asdfgh0318/arabskie_gogle/cad/img/shroud.png

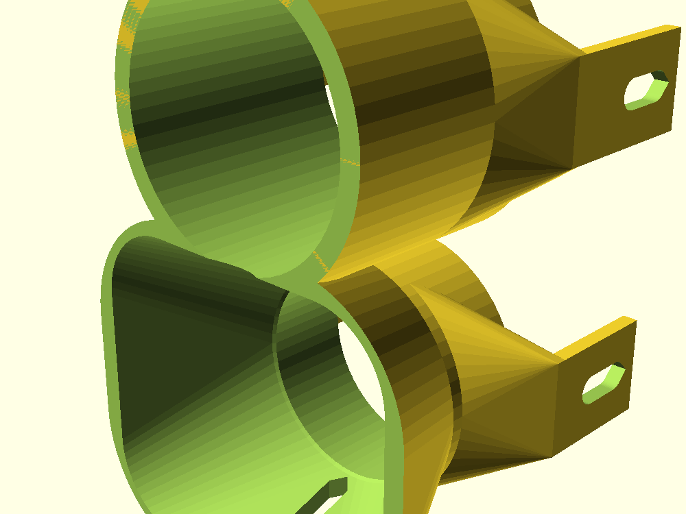
cad/img/shroud.png
