asdfgh0318/arabskie_gogle/cad/img/tac_front.png

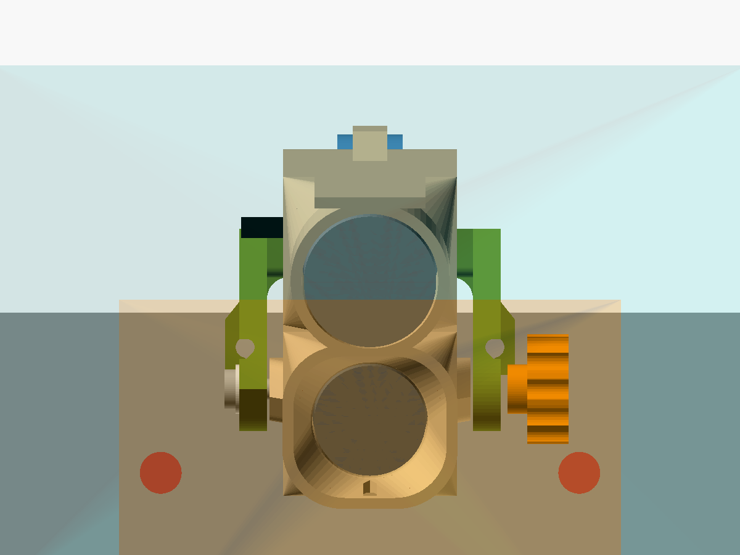
cad/img/tac_front.png
