asdfgh0318/arabskie_gogle/README.md

# arabskie_gogle

Termowizja na hełmie: gogle FPV (Fat Shark Dominator HDO?) + dwukanałowa kamera termowizyjna
(BZB UAS) + mocowania GoPro (VHB) na kasku Protec + mały sterownik (ESP32 / XIAO) z przyciskami.

Status: **definiowanie założeń** — patrz [ZALOZENIA.md](ZALOZENIA.md). Nic nie projektujemy,
dopóki cele i otwarte pytania nie są zamknięte.

## Struktura
- `ZALOZENIA.md` — cele, wymagania, otwarte pytania (dokument nadrzędny)
- `research/` — notatki z researchu (pozycja kamer, ergonomia, protokół kamery)
- `papers/` — pobrane źródła (PDF) + plik z cytatami
- `cad/` — modele do druku 3D (adapter gogle↔kask, mocowanie kamery, obudowa sterownika)
- `firmware/` — sterownik kamery (ESP32/XIAO)
- `photos/` — zdjęcia sprzętu, wymiary
