asdfgh0318/arabskie_gogle/papers/extracts_pod_ergonomics_mount.md

# Extracts — pod ergonomics (gloved, blind) and attachment to the HDO2 shell

Track 07c of `arabskie_gogle`. Verbatim passages from files in `papers/` that I downloaded **and read**,
with page/section. Line breaks are joined. "[img]" marks values read from a figure/drawing image
(the image is saved in `papers/pod_ergo_img/`), not from text. The report is
`research/07c_pod_ergonomics_mount.md`; where the two differ, **these source files govern**.

Page numbers: MIL-STD-1472H "p." = printed page number (PDF page = printed + 17).
HIDH "p." = printed page number.

---

## E1. MIL-STD-1472H, DoD Design Criteria Standard: Human Engineering (15 September 2020)
File: `pod_MIL-STD-1472H_2020_human_engineering.pdf` / `.txt` (from everyspec.com, "Downloaded from
https://www.everyspec.com" on every page). Pages 34, 70 and 71 are image-only in the PDF; they were
rendered and read: `pod_ergo_img/MIL1472H_p34_fig1_shape_coding_dims.png`,
`MIL1472H_p70_fig8_knobs_text.png`, `MIL1472H_p71_fig9_knob_shapes.png`.

**E1.1 Handwear (§5.1.1.1.1.5, p.27).**
> "5.1.1.1.1.5 Compatibility with handwear. Controls shall be compatible with handwear to be utilized in the
> anticipated environment. Unless specified for glove use, all dimensions cited herein are for bare hands and
> shall be adjusted for use with gloves or mittens (see language regarding gloves in table VII)."

**E1.2 Spacing (§5.1.1.3.7, p.31).**
> "5.1.1.3.7 Spacing. Minimum spacing between controls shall comply with table III. Spacing between a control
> and any adjacent obstruction shall be as shown by the figures referenced in table III. Minimum spacing shown
> shall be increased for operation with gloves, mittens, or CBRNE or other mission-required PPE when such
> operation is a system requirement (see 5.1.1.1.1.5 and table VII)."

**E1.3 Table III, "Minimum edge-to-edge separation distances for mechanical controls" (p.32).** Rows/columns
as extracted:
> "Push Buttons 2/ | 13 mm (0.5 in) [toggle] | See figure 14 | 13 mm (0.5 in) [continuous rotary] | 13 mm (0.5 in)
> [rotary selector] | 13 mm (0.5 in) [thumbwheel]"
> "Continuous Rotary Controls | 19 mm (0.75 in) | 13 mm (0.5 in) | See figure 12 | 25 mm (1 in) | 19 mm (0.75 in)"
> "NOTES: 1/ All values are for one-hand operation. All values are for bare-handed operation. 2/ For push buttons
> not separated by barriers."

**E1.4 Table IV, coding (p.32–33).** Shape, size, location and mode-of-operation coding are marked as
"Improves nonvisual identification (tactile and kinesthetic)"; shape, size and mode of operation are marked
"May be less effective if user wears gloves".

**E1.5 Size coding (§5.1.1.4.3, p.33).**
> "5.1.1.4.3 Size-coding. No more than three different sizes shall be used to code controls for discrimination by
> absolute size."
> "5.1.1.4.3.2 Knob diameter. When knob diameter is used as the coding parameter, the differences between
> diameters shall be not less than 13 mm (0.5 in)."
> "5.1.1.4.3.3 Knob thickness. When knob thickness is the coding parameter, the differences between thicknesses
> shall be not less than 10 mm (0.4 in)."

**E1.6 Shape coding (§5.1.1.4.4, p.33).**
> "5.1.1.4.4.1.1 Interference. The coded feature shall not interfere with ease of control manipulation."
> "5.1.1.4.4.1.2 Identifiable by hand. Shapes shall be identifiable by hand and eye regardless of the position and
> orientation of the control knob or handle."
> "5.1.1.4.4.1.3 Identifiable with gloves. Shapes shall be tactually identifiable when gloves must be worn."
> "5.1.1.4.4.1.4 Number of shapes. The number of shapes to be identified by each user based on absolute
> discrimination shall be not more than 10."

**E1.7 Shape coding, p.34 (image-only page, read from render).**
> "5.1.1.4.4.1.5 Attached to shaft. Shape-coded knobs and handles shall be positively and non-reversibly attached
> to their shafts to preclude incorrect attachment when replacement is required."
> "5.1.1.4.4.1.6 Touch alone. For knobs that must be recognized by touch alone, easily recognizable knob shapes
> shall be used (see figure 1)."
> "5.1.1.4.4.2 Control dimensions. Minimum control dimensions when users must distinguish controls by shape alone
> shall be as follows: a. Height: 13 mm (0.5 in) or larger. b. Width: 13 mm (0.5 in) or larger. c. Depth: 6.5 mm
> (0.25 in) or larger."
Figure 1 "Easily recognizable knob shapes" shows cylinder, disc, cube, cross, triangle prism, dome, bar, ring,
etc. [img].

**E1.8 Blind operation (§5.1.1.6, p.35).**
> "5.1.1.6 Blind operation. Where "blind" operation is necessary, hand controls shall be shape coded, or separated
> from adjacent controls by at least 125 mm (5 in) (see 5.1.1.4.2 and 5.1.1.4.4)."

**E1.9 Gloss (§5.1.1.4.5.5, p.35).**
> "5.1.1.4.5.5 Gloss finishes. Gloss finishes shall not be used in areas subject to darkened conditions for night
> operations."

**E1.10 Accidental actuation (§5.1.1.7.4, p.35–36).**
> "b. Recess, shield, or otherwise surround the control by physical barriers. The control shall be entirely
> contained within the recess or barrier envelope."
> "e. Provide the control with movement resistance (e.g., viscous or coulomb friction, spring-loading, or inertia)
> so that definite or sustained effort is required for actuation."
> "g. Design the control for operation by rotary action."

**E1.11 Table VII, Keyboards (p.47).** Dimensions (square): "Minimum 10 mm (0.4 in) [bare] | 19 mm (0.75 in)
[arctic mittens 1/] | 15 mm (0.6 in) [2/]"; "Preferred 13 mm | 19 mm | 18 mm (0.7 in)". Vehicle applications:
"Minimum 10 mm (0.4 in) [bare] 19 mm (0.75 in) [gloved hand] 2.8 N (9.9 oz) [numeric input]"; "Preferred ... 13 mm
(0.5 in) [separation]"; "Maximum 25 mm (1 in) 25 mm (1 in) 6.7 N (23.7 oz)".
> "1/ Trigger finger type; other parameters are unchanged from those of bare-handed operation."
> "2/ Standard cotton flame-resistant anti-flash gloves (i.e., Navy flash gloves [as defined in MIL-G-2874])."
> "3/ For membrane keys, preferred displacement is 0.7 mm (0.03 in) and resistance shall be not less than 2.0 N
> (7.2 oz). Membrane keys shall also incorporate positive tactile feedback (e.g., "snap" action)."
Column headers (verification): "Bare Hand | Arctic Mittens 1/ | 2/" — so in Table VII **19 mm belongs to arctic
mittens** (note 1/, trigger-finger type) and **15 mm to flash gloves** (note 2/). The "Vehicle Applications"
gloved 19 mm carries no footnote.

**E1.12 Figure 6, discrete rotary selector switch (p.66).** Displacement (A): "Minimum 15° (262 mrad) [1/]
30° (525 mrad) [2/]"; "Maximum 40° (700 mrad) 90° (1,570 mrad)". (Verification, same figure:) Dimensions
"L, Length 25 mm (1 in) min, 100 mm (4 in) max; W, Width 25 mm max; H, Depth 16 mm (0.625 in) min, 75 mm (3 in)
max"; Resistance "115 mN·m (1 in-lbf)" min, "680 mN·m (6 in-lbf)" max. p.67: "5.1.4.1.1.1.4 Positions. A rotary
selector switch that is not visible to the user during normal system operation shall have no more than 12
positions."
> "1/ For facilitating performance." "2/ When special engineering requirements demand large separation or when
> tactually ("blind") positioned controls are required."
Separation: "One-hand random ... Minimum 25 mm (1 in) ... Preferred 50 mm (2 in)".

**E1.13 Knob mounting (§5.1.4.1.1.1.9, p.67).**
> "5.1.4.1.1.1.9 Knob mounting. The rotary selector knob attachment shall preclude the possibility of the knob
> slipping on the shaft and the knob being replaced with the pointing end opposite from its correct position."

**E1.14 Knobs, p.70–71 (image-only pages, read from renders).**
> "5.1.4.1.2.1.3 Shapes. Knobs that perform the same function shall have the same shape." (p.70)
> "5.1.4.1.2.1.4 Rims. All rotary adjustment knobs shall have rims with surfaces capable of obtaining a secure
> grasp." "5.1.4.1.2.1.4.1 Knurled surfaces. Very small knobs shall have knurled surfaces to provide maximum
> torqueing capability." "5.1.4.1.2.1.4.2 Serrated rims. Intermediate and larger size knobs shall have serrated
> rims for low torque applications." "5.1.4.1.2.1.6 Rounded edges. All edges shall be rounded in order to minimize
> the potential injuries associated with small, sharp knob designs." "5.1.4.1.2.1.7 Dimensions, torque, and
> separation. The dimensions of knobs shall be within the limits specified on figure 10. Within these ranges, knob
> size is relatively unimportant, provided the resistance is low and the knob can be easily grasped and
> manipulated." (p.71)
Figure 9 "Recommended knob shapes": (A) knobs for more than one full turn = round/fluted/knurled; (B) less than
one turn = pointer/bar shapes [img].

**E1.15 Figure 10, Knobs (p.72).** Dimensions: "A, Fingertip Grasp: H, Height 13 mm (0.5 in) min, 25 mm (1 in)
max; D, Diameter 10 mm (0.4 in) min, 100 mm (4in) max"; "B, Thumb and Finger Encircled: H 13 mm min, 25 mm max;
D 25 mm (1 in) min, 75 mm (3 in) max". Torque maximum: "32 mN·m (4.5 in-ozf)" for "≤25 mm (1 in) Diameter Knobs",
"42 mN·m (6 in–ozf)" for ">25 mm". Separation "S, One Hand Individually: Minimum 25 mm (1 in), Optimum 50 mm
(2 in)".
> "5.1.4.1.2.1.7.2 Low resistance. Knobs shall have resistance as low as possible without permitting the setting
> to be changed by vibration or merely touching the control."

**E1.16 Figure 11, ganged knobs (p.73)** separation row:
> "25 mm (1 in), add 13 mm (0.5 in) for gloves" (column A) and "50 mm (2 in), add 25 mm (1 in) for gloves" (column B)
(the only explicit "add … for gloves" knob separation figure found; it is for ganged knobs.)

**E1.17 Push buttons (§5.1.4.2.1.1, p.80).**
> "5.1.4.2.1.1.2 Shape. The push button surface shall be concave (indented) to fit the finger."
> "5.1.4.2.1.1.2.1 Concave shape impractical. When a concave surface is impractical, the surface shall provide a
> high degree of frictional resistance."
> "5.1.4.2.1.1.3 Positive indication. A positive indication of control activation shall be provided (e.g., snap
> feel, audible click, or integral light)."
> "5.1.4.2.1.1.3.1 Tactile feedback. Tactile feedback shall be the primary form of positive indication."
> "5.1.4.2.1.1.4 Channel or cover guard. A channel or cover guard shall be provided when accidental actuation of
> the control must be prevented."

**E1.18 Figure 14, Push button (finger- or hand-operated) (p.81).**
Dimensions (D, diameter): "Fingertip Bare Hand 10 mm (0.4 in) min, 25 mm (1 in) max; Gloved Hand 1/ 19 mm
(0.75 in) min"; "Thumb Bare 19 mm min, 25 mm max; Gloved 25 mm (1 in) min"; "Palm Bare 40 mm, Gloved 50 mm".
Resistance: "Single Finger 2.8 N (10 oz) min, 11 N (40 oz) max; Different Fingers 2/ 1.4 N min, 5.6 N max; Thumb
or Palm 2.8 N min, 23 N (80 oz) max".
Displacement (A): "Fingertip Minimum 2 mm (0.08 in), Maximum 6 mm (0.25 in); Thumb or Palm 3 mm (0.12 in) min,
38 mm (1.5 in) max".
Separation (S): "Single finger Bare 13 mm (0.5 in) min, 50 mm (2 in) preferred; Single finger Gloved 25 mm (1 in)
min; Single Finger Sequential 3/ 6 mm min, 13 mm preferred; Different Finger 3/ 6 mm min, 13 mm preferred; Thumb
or Palm 3/ 25 mm min, 150 mm preferred".
> "1/ For standard cotton flame-resistant anti-flash gloves (i.e., Navy flash gloves [as defined in MIL-G-2874]),
> add 5 mm (0.2 in) to Diameter (D) of bare hand dimension."
> "2/ Actuated at same time." "3/ Where gloved hand criteria are not provided, minimum shall be suitably adjusted."
> "NOTE: Figure 14 does not apply to keyboards (see 5.1.3.2)."
Note (mine): the gloved fingertip column gives 19 mm, while footnote 1/ (10 + 5) gives 15 mm. The standard does
not reconcile the two. (Verification: 19 mm equals Table VII's arctic-mitten value, 15 mm its flash-glove value,
E1.11. The gloved separation "25 mm" has no footnote, so no glove type is attached to it.)
Also on Fig. 14 (verification): Palm "Maximum 70 mm (2.8 in)" bare.

## E2. NASA Human Integration Design Handbook (HIDH), NASA/SP-2010-3407/REV1 (approved 06-05-2014)
File: `pod_NASA_HIDH_SP-2010-3407_Rev1.pdf` / `.txt` (nasa.gov). Its history log also lists a 2022 revision of
Section 4 only.

**E2.1 §10.4.2.1.4–10.4.2.1.5, p.969; Figure 10.4-1, p.970.**
> "Except for use of push buttons in keyboards, control dimensions, resistance, displacement, and separation
> between adjacent edges of finger or hand-operated push buttons should conform to the criteria in 10.6-7."
> "10.4.2.1.5 Interlocks or Barriers" (heading), then: "Mechanical interlocks or barriers may be used instead of
> the spacing required by Figure 10.4-1."
> "Figure 10.4-1 Requirements for push buttons (finger- or hand-operated). Source: MIL-STD-1472F"

**E2.2 §10.4.11, p.1019.**
> "Extravehicular activity gloves reduce tactility even when they are not pressurized. Thus, performance with
> cursor control devices that require fine motor movements is negatively affected when wearing gloves: movement
> times are slower and accuracy is also reduced. Some devices are less affected by the lack of tactility. In a
> ground-based study on gloved cursor control device (CCD) use, discrete devices with 4-way operation led to better
> performance than continuous or 2-way devices (Thompson, Meyer, Sandor, Holden, 2009)."

**E2.3 §10.5.6 Obscured controls, p.1023.**
> "Controls designed to be out of view while being operated should be spaced or shaped/textured such that the
> control can be identified with a pressurized gloved hand without line of sight."

**E2.4 §11.3.4 (suit), p.1122.**
> "Spacesuit gloves degrade hand and finger range of motion, tactile feedback, and proficiency compared to
> bare-hand operations. Depending on the design, dexterity can generally be compared to that with heavy work
> gloves. However, because of reduced tactile feedback, the size and shape of objects is more difficult to
> discern."

## E3. 3M VHB Tape 5952, Technical Data Sheet (Oct 2022, official 3M)
File: `pod_3M_VHB_5952_TDS_2022-10.pdf` / `.txt` (multimedia.3m.com).

**E3.1 p.1.**
> "3M™ VHB™ Tape 5952 is a 0.045 inch (1.1 mm) thick black double-sided acrylic foam tape with PE film liner. The
> modified acrylic adhesive on both sides bonds to a broad range of high, medium and medium/low surface energy
> substrates including metals, glass and a wide variety of plastics and paints, including many powder coated
> paints. The very conformable foam provides good contact between substrates even when they are slightly
> mismatched."
> "The following technical information and data should be considered representative or typical only and should
> not be used for specification purposes."

**E3.2 Typical performance, p.2–5** (peel p.2–3, normal tensile and overlap shear p.3, static shear and minimum
application temperature p.4, shear modulus p.5).
> "90° Peel Adhesion 22 lb/in ... Test Method: ASTM D3330 ... Backing: 5 mil Aluminum Foil"; "90° Peel Adhesion
> 39 N/cm ... ASTM D3330"
> "Normal Tensile 480 kPa ... ASTM D897 ... Dwell/Cure Time: 72.0 ... Substrate: Aluminum ... Notes: 1 in.²
> (6.45 cm²), Jaw Speed 2 in./min. (50 mm/min.)"
> "Overlap Shear Strength 550 kPa ... ASTM D1002 ... Notes: 1 in² (6.45 cm²), Jaw Speed 0.5 in/min (12.7 mm/min)"
> "Static Shear 1000 g ... ASTM D3654 ... Temp C: 23C ... Substrate: Stainless Steel ... 0.5 in² (3.23 cm²). Will
> hold listed weight for 10,000 minutes (approximately 7 day)." (500 g at 66 °C; 250 g at 93 °C)
> "Minimum Application Temperature 10 °C"
> "Shear Modulus 3 x 10^5 Pa"

**E3.3 Design Considerations, p.6–7.**
> "3M™ VHB™ 5952 family tapes bond well to high (HSE), medium (MSE), and medium/low (M/LSE) surface energy
> materials."
> "While the 3M™ VHB™ Tapes will conform to a certain amount of irregularity, they will not flow to fill gaps
> between the materials. For bonding rigid materials with normal flatness, consider use of tapes with thickness
> of 45 mils (1.1 mm) or greater. As the substrate flexibility increases thinner tapes can be considered."
> "As a general rule, for static loads, approximately four square inches of tape should be used for each pound
> (57 cm² of tape per kg) of weight to be supported in order to prevent excessive creep. For dynamic loads a useful
> design factor is 12 lb/in2 (85 kPa) for most dynamic stresses in general applications."
> "Performance in Severe Cold Temperature can be challenging. Applications which require performance at severe
> cold temperatures must be thoroughly evaluated by the user if the intended use will subject the tape product to
> high impact stresses."

**E3.4 Application, p.7–8.**
> "Clean: Most substrates are best prepared by cleaning with a 50:50 mixture of isopropyl alcohol (IPA*) and water
> prior to applying 3M™ VHB™ Tapes."
> "• Abrasion: Abrading a surface, followed by cleaning with IPA/water, can remove heavy dirt or oxidation and can
> increase surface area to improve adhesion." "• Adhesion Promoters: Priming a surface can significantly improve
> initial and ultimate adhesion to many materials such as plastics and paints."
> "Typically, good surface contact can be attained by applying enough pressure to insure that the tape experiences
> approximately 15 psi (100 kPa) pressure. Either roller or platen pressure can be used. Note that rigid surfaces
> may require 2 or 3 times that much pressure to make the tape experience 15 psi."
> "Ideal application temperature range is 70°F to 100°F (21°C to 38°C)." "Initial tape application to surfaces at
> temperatures below these suggested minimums is not recommended because the adhesive becomes too firm to adhere
> readily. However, once properly applied, low temperature holding is generally satisfactory."
> "At room temperature approximately 50% of ultimate bond strength will be achieved after 20 minutes, 90% after 24
> hours and 100% after 72 hours."
> (verification, p.8) "Ultimate bond strength can be achieved more quickly (and in some cases bond strength can be
> increased) by exposure of the bond to elevated temperatures (e.g. 150°F [66°C] for 1 hour)."
> (verification, p.7) "Bond Flexibility: … Suitable design modifications or periodic use of rigid fasteners or
> adhesives may be needed if additional stiffness is required."
Peel conditions (verification, p.2): the "22 lb/in" row is 24 h dwell at 23 °C, 5 mil Al foil backing; the
"39 N/cm" row is 72 h dwell at "Temp C: 70C" on stainless steel. The 2024 sheet (E5) prints "Stainless Steel …
39 N/cm (22 lb/in)". Overlap shear substrate is not stated in the 2022 sheet; E5.1 gives stainless steel.

## E4. 3M VHB Tape 5952, TDS (April 2019 layout; mirror startsafety.uk) — surface-energy chart
File: `pod_3M_VHB_5952_TDS_2019-04_startsafety.pdf`; chart image `pod_ergo_img/3M_VHB_5952_2019_p6_surface_energy_chart.png`.
**E4.1 p.6, chart "Relationship of Adhesion and Surface Energy for 3M™ VHB™ Tape Adhesive Families" [img].**
Columns: "1100-400 (High)": Aluminum, Stainless Steel, …, Glass; "50-42": Polyimide, Phenolic, Nylon, Alkyd
Enamel, **Polyester**, Epoxy Paint, Polyurethane; "39-38 (Medium)": **ABS, Polycarbonate**, PVC, PPE, Acrylic, PU
Enamel, Powder Paint; "37-36": PVA, Polystyrene, Acetal, PVDF Paint, Powder Paint; "33-18 (Low)": EVA,
Polyethylene, Polypropylene, PVF, Silicone, PTFE. Units "Surface Energy (Dynes/cm)".
Bars [img, re-measured in verification on the 1300 × 900 px render: column-label centres 39-38 at x ≈ 497,
37-36 at x ≈ 684; dark→light transition 4941 x = 560, 5952 x = 685, RP x = 525]: "Generally good adhesion" (dark)
extends for the **4941 Family** ≈ ⅓ of the way from 39-38 to 37-36, for the **5952 Family** to the **37-36
column** (the earlier "≈ two-thirds" was wrong), for the **RP Family** ≈ 0.15 of the way past 39-38; the rest
of each bar is "Primer may be needed for good adhesion". The same chart in the 4910 sheet (E6, PDF p.7) shows
the same three families and **no 4910 bar**.
> "NOTES: There are a wide variety of formulations, surfaces finishes and surface treatments available on
> substrate materials which can affect adhesion. This chart is intended to provide only a rough estimate of the
> adhesion levels which can be expected on some common materials relative to a reference surface such as
> aluminum." "Foam type can affect and/or limit maximum adhesive strength."

## E5. 3M VHB Tape 5952, TDS (Aug 2024; Digi-Key mirror) — bond build vs time
File: `pod_3M_VHB_5952_TDS_2024-08_digikey.pdf`; image `pod_ergo_img/3M_VHB_5952_2024_p4_bond_build_vs_time.png`.
**E5.1 p.2** "Overlap Shear ASTM D1002, ISO Stainless Steel 550 kPa (80 lb/in²)"; "Normal Tensile ASTM D897
Aluminum 480 kPa (70 lb/in²)".
**E5.2 p.4 chart "Typical Bond Build vs. Time" [img]:** ROOM TEMP ≈50 % at 20 min, ≈80 % at 1 h, ≈90 % at 24 h
(the point under the "24 HOURS" label reads ≈ 90–91 %; corrected from ≈95 % in verification), 100 % at 72 h; **50 °F ≈30 % at 20 min, ≈50 % at 24 h, ≈70 % at 72 h**; 150 °F or ABRADE ≈80 % at 20 min, ≈100 %
by 1 h. Note under chart: "*Note: Chart describes general performance of 3M™ VHB™ Tapes. Actual bond strength vs.
time will depend on several factors including tape and substrate".

## E6. 3M VHB Tape 4910, TDS (Aug 2018; TBP Converting reprint of the 3M sheet)
File: `pod_3M_VHB_4910_TDS_2018-08_tbp.pdf` / `.txt`.
> p.1 "3M™ VHB™ Tape 4910 is a 0.040 inch (1.0 mm) thick clear double coated acrylic foam tape with PE film
> liner. The general purpose acrylic adhesive on both sides bonds to a broad range of high surface energy
> substrates including metals, glass and easier to bond paints and plastics."
> p.2 "90° Peel Adhesion 26 N/cm 15 lb/in ASTM D3330 ... Stainless Steel"; "Normal Tensile 690 kPa 100 lb/in² ASTM
> D897 ... Aluminum"; "Dynamic Overlap Shear 480 kPa 70 lb/in² ASTM D1002 ... Stainless Steel ... 1 in² (6.45
> cm²), Jaw speed 0.5 in/min (12.7 mm/min). Peak force to separate is measured."
> p.6 "3M™ VHB™ 4910 family tapes bond well to high (HSE) surface energy materials."
No T-peel value is given in this sheet or in E3.

## E7. 3M VHB Structural Glazing Tapes B23F/G23F, Technical Data (August 2014, official 3M)
File: `pod_3M_VHB_SGT_B23F_G23F_TDS_2014.pdf` / `.txt`.
> "Dynamic Loads: For dynamic tensile or shear loads, such as wind loads, a design strength of 12 psi (85 kPa) is
> used for 3M™ VHB™ Structural Glazing Tapes. This design strength guideline provides a safety factor of >5 and
> was established based on material property testing as well as ASTM dynamic load testing for curtain wall
> applications."
> "Static Loads: For static tensile or shear loads, such as dead weight loads with no mechanical support, snow
> loads and other long-term loads, a design strength of 0.25 psi (1.7 kPa) is used for 3M™ VHB™ Structural
> Glazing Tapes. This means 4 in2 of tape per 1 lb load (60 cm2 of tape per 1 kg load) should be used to support
> constant stress loads. This guideline provides a safety factor of >5."
(Scope note: these sentences are written for the structural glazing tapes; the same 85 kPa / 57 cm²/kg numbers
appear without the ">5" statement in the 5952 and 4910 sheets, E3.3, E6.)

## E8. 3M VHB Tape Cold Temperature Performance, Technical Bulletin (January 2002, 70-0707-3991-0)
File: `pod_3M_VHB_cold_temperature_bulletin_2002.pdf` / `.txt` (Ellsworth mirror of the 3M bulletin).
> "As the adhesive and core materials become firmer, the performance generally increases measured by the standard
> test methods described in the VHB tape product information page."
> "The exception to this performance-temperature relationship is at very low temperatures when high impact stress
> along with high frequencies are encountered. The acrylic polymer from which VHB Tapes are made goes through its
> glass transition temperature at approximately -40°F (-40°C). At low temperatures, when the adhesive and foam core
> are firm or glassy, the ability to absorb impact energy is reduced."
> "we suggest that a thorough evaluation be conducted by the user at actual use conditions on applications where
> high impact stress is expected at low temperatures."
> (verification) "This type of shocky behavior is demonstrated by the lower performance of VHB Tape 9473 as noted
> at -65°F (-54°C) in Figure 1." Figure captions: "T-Peel vs. Temperature Tape F-9473PC Adhesion to Aluminum";
> "Dynamic Normal Tensile vs. Temperature Tape 4945 to Aluminum Blocks".

## E9. 3M VHB Tape Design Guide (official 3M, 22 pp.)
File: `pod_3M_VHB_tape_design_guide.pdf` / `.txt`.
> p.8 "• EXPANSION/CONTRACTION — Tapes can typically tolerate differential movement in the shear plane up to three
> times their thickness." "• COLD TEMPERATURES — Evaluate applications that require performance at severe cold
> temperatures to assure proper adhesion performance."
> p.17 "For some challenging substrates, a primer or adhesion promoter may improve the reliability of the bond.
> Consult with 3M Technical Service to determine if a surface preparation step will be required for your
> application." Primer table lists "AP111", "AP115", "Primer 94", "Primer UPUV". "• HIGHER ADHESION — Prime
> surfaces to increase adhesion — especially for paint or plastic surfaces."
(verification) The primer table gives solvent, VOC, colour, flash point and coverage only — **no substrate
mapping**. AP111 "Isopropyl Alcohol (IPA)", flash point "52°F (11°C)"; AP115 "Isopropyl Alcohol and Water",
"53°F (12°C)"; Primer 94 solvent "See SDS", flash point "-4°F (-20°C)"; Primer UPUV "-5°F (-21°C)".

## E10. GoPro adhesive mounts (already in `papers/`, re-read)
File: `gopro_AACFT-011_universal_adhesive_page.txt` l.154; `gopro_AACFT-001_product_page.txt` l.144.
> "Apply mount to a clean, smooth surface (non-porous and non-textured) and let it sit at room temperature for at
> least 24 hours to ensure it sticks properly." (AACFT-011)
> "Attach your GoPro to curved and flat surfaces with these industrial-strength waterproof adhesive mounts. Can be
> removed by heating the adhesive bond with a hair dryer then peeling off the mount." (AACFT-001)
Neither page names the adhesive grade, area or a load rating.

## E11. Alps EC11E series catalog (Alps Alpine, "Update：2510", 2 pp.)
File: `pod_Alps_EC11E_catalog_2510.pdf` / `.txt`; drawings `pod_ergo_img/Alps_EC11E_drawing2_0.5mm_travel.png`,
`Alps_EC11E_drawing3_1.5mm_travel.png`.
**E11.1 p.1 table (text):**
> "EC11E09244BS Vertical Flat 20 10±7mN・m 18 9 With 0.5" (columns: Products No., Control part orientation,
> Actuator configuration, Actuator length (mm), Detent torque, Number of detent, Number of pulse, Push-on switch,
> Travel of push-on switch (mm))
> "EC11E09244AQ Vertical Flat 20 10±7mN・m 18 9 With 1.5"
> "1. This catalog shows only outline specifications. When using the products, please obtain formal specifications
> for supply."
**E11.2 p.2 Drawings No.2 (0.5 mm travel) and No.3 (1.5 mm travel) [img]:** shaft "ø6 0/−0.05", flat "4.5 0/−0.1",
flat length "10" from the tip, "(20)" shaft length, "24.5" overall from the reference plane, "4.5" body step,
"C1" tip chamfer, "R0.5"; body "11.7" wide, "6"+"6" high, "7.5 max."; mounting holes "12.5±0.05", "5", "7", "7.5",
"5-ø1 +0.1/0 hole", "Tolerance : ±0.1"; "Switch travel 0.5" (No.2) / "1.5" (No.3). No push-on switch operating
force and no shaft push/pull strength are given in this catalog.

## E12. Omron B3S datasheet (already in `papers/ctrl_omron_B3S.pdf`, re-read)
**E12.1 p.1 (text):** "Operating force (OF) 1.57 N {160 gf} max. [B3S-1@00] 2.26 N {230 gf} max. [B3S-1@02]";
"Pretravel (PT) 0.25 +0.2/–0.1 mm"; "Shock resistance Destruction: 1,000 m/s2 {approx. 100G} max. Malfunction:
100 m/s2 {approx. 10G} max."; "Durability Standard force models (1.57 N {160 gf}): 500,000 operations min."
**E12.2 p.2 dimensions [img, `pod_ergo_img/Omron_B3S_p2_dimensions.png`]:** body "6" × "6.6" (with terminals
4.5 pitch), plunger "3.3 dia.", total height "4.3", cover height "3.4" → plunger stands 0.9 mm proud [calc];
"Note: Unless otherwise specified, a tolerance of ±0.3 mm applies to all dimensions."

## E13. Prusament PETG Technical datasheet, v1.1 (16-02-2022), Prusa Polymers
File: `pod_Prusament_PETG_TDS_v1.1_2022.pdf` / `.txt` (copy hosted by 3dprintergear.com.au; Prusa header).
> p.2 "Heat Deflection Temperature (0.45 MPa) [°C] 68 ISO 75"; "Tensile Yield Strength for Filament [MPa] 46 ± 1";
> "Interlayer Adhesion [MPa] 18 ± 4 Prusa Polymers"
> p.2 printed specimens, Horizontal / Vertical xz: "Tensile Yield Strength [MPa] 47 ± 2 50 ± 1"; "Tensile Modulus
> [GPa] 1.5 ± 0.1 1.6 ± 0.1"; "Elongation at Yield Point [%] 5.1 ± 0.1 5.1 ± 0.1"; "Flexural Strength [MPa] 66 ± 2
> 70 ± 1"; "Flexural Modulus [GPa] 1.7 ± 0.1 1.6 ± 0.1"; "Impact Strength Charpy Notched [kJ/m2](4) 6±1 3±1"
> p.3 "Values are significantly dependent on print settings, operator experiences, and surrounding conditions."

## E14. Bayer MaterialScience, "Snap-Fit Joints for Plastics – A Design Guide" (2005)
File: `pod_Bayer_SnapFit_Joints_for_Plastics_2005.pdf` / `.txt` (copy hosted by SparkFun); Table 1 image
`pod_ergo_img/Bayer_snapfit_p9_table1_cantilever_equations.png`.
> p.11 "In general, during a single, brief snap-fitting operation, partially crystalline materials may be stressed
> almost to the yield point, amorphous ones up to about 70% of the yield strain."
> p.12 Table 2 "General guide data for the allowable short-term strain for snap joints (single joining operation);
> for frequent separation and rejoining, use about 60% of these values": "Bayblend PC/ABS 2.5%", "Makrolon® PC
> 4%".
> p.9 Table 1 [img]: design type 1 (constant cross section), rectangle: "y = 0.67 · ε·l²/h"; design type 2
> (thickness decreasing to one-half): "y = 1.09 · ε·l²/h"; deflection force, rectangle: "P = bh²/6 · Es·ε/l".
> p.9 "Es = secant modulus".
(PETG is not in Table 2; the 70 % rule above is the only general guidance applied.)

## E15. Alps EC11E09244BS product detail page (added in verification)
File: `pod_place/alps_EC11E09244BS_detail.txt` (+ `.html`), already in `papers/` from another pod track;
shaft-variety figure `pod_place/alps_product_detail_fig_ec11_c_12_en_cb61b6196a.gif`. Read in verification.
> L18 "Standard"; L22–23: "The product is mass-produced and recommended for new designs."
> L66–67: "Actuator length" / "20mm"
> L93–96: "Detent torque" / "10±7mN・m" / "Push-pull strength" / "100N"
> L101–106: "Contact arrangement" / "Single pole single throw (Push-on)" / "Travel" / "0.5±0.3mm" /
> "Operating force" / "6(+2.5, -2)N"
> L111–112: switch "Operating life" / "20,000 times"
Figure c_12 "Flat Type" [img]: collar "ø7", "C1", "ø6"; table L1 / LB / ℓ: "20 | 7 | 10 (12)" (row
highlighted). L137: "Values in parentheses apply to products without push-on switch." So for the push
versions LB = 7 (collar length), ℓ = 10 (flat).
These figures are for the **BS** (0.5 mm travel). The **AQ** (1.5 mm) product page was not retrieved; its
force is unknown.

## E16. Bourns PEC11R datasheet, REV. D04/26 (added in verification)
File: `pod_bourns_PEC11R.pdf` / `.txt` (4 pp.), already in `papers/`. Read in verification.
> p.1, txt L55–57: "Torque … Detent 30 to 90 gf-cm (0.41 to 1.25 oz.-in.)"; "Running 10-70 gf-cm"
> p.1, txt L47: "IP Rating … IP 40"
> p.1, txt L102–106: "Switch Travel … 0.5 ± 0.3 mm"; "Switch Actuation Force … 610 ± 306 gf (8.47 ± 4.24 oz.in.)"
> p.3, txt L314–316: "Detent Option" … "1 = 18 Detents (18 pulses)" … "3 = 12 Detents (12, 24 pulses)"
> p.3, txt L306–307: "How To Order" / "PEC11R 4 0 20 F - S 0012"; L311: "4 = PC Pin Horizontal / Rear Facing"
> p.3, txt L322: "F = Metal Flatted Shaft"; L324: "S = Push Momentary Switch"; L327: "0012 = 12 Pulses per 360 ° Rotation"
Drawing labels in the PDF text layer (txt L32–158, drawings on p.1–2): "6.0 ± 0.1" (DIA.), "4.5 +0/-.05" (across the
flat), "M7 x 0.75" (bushing); txt L81–83: "Hardware … One flat washer and one mounting nut supplied with each
encoder". (Fuller drawing reading: `extracts_pod_components.md` E4.8.)
Conversions [calc]: 610 ± 306 gf = 2.98–8.98 N; 30–90 gf·cm = 2.9–8.8 mN·m; 12 detents = 30°.

## Verification (2026-11-03)
All passages above were re-checked against the source files. Changes made to this file:
- E1.11: added the Table VII column headers — 19 mm is the arctic-mitten value, 15 mm the flash-glove value.
- E1.16: "[A]/[B]" (column letters) renamed "(column A/B)" so they are not read as evidence tags.
- E1.18: noted that 19 mm matches Table VII's arctic-mitten value and that the gloved separation has no footnote;
  added palm maximum 70 mm.
- E1.12: added Fig. 6 dimensions/resistance and §5.1.4.1.1.1.4 (≤ 12 positions if not visible).
- E3.4: added the 66 °C / 1 h acceleration and the "rigid fasteners" sentence (both used in the report); peel
  test conditions clarified.
- E4.1: bar ends re-measured in pixels; 5952 reaches the 37-36 column (not "two-thirds"); 4910 sheet's chart has
  no 4910 bar.
- E5.2: room-temperature 24 h value corrected from ≈95 % to ≈90 %.
- E8: added the "shocky" sentence and the figure captions (T-peel of F-9473PC) cited in the report.
- E9: primer table has no substrate mapping; flash points added.
- E15, E16: new (sources already in `papers/`, read in verification).
Arithmetic re-run: `/tmp/claude-1000/pod_research/verify-ergo/check.py` (scratch).
