asdfgh0318/arabskie_gogle/papers/extracts_placement.md

# Extracts — camera placement / parallax / latency track

Verbatim passages backing `research/01_camera_placement_parallax_latency.md`.
Every passage below was read in the PDF named (text extracted with `pdftotext -layout`; OCR
artefacts of old scans kept as-is and marked [sic]). "pdf p." = page index in the file;
"printed p." = page number printed on the page, where there is one.
IDs (E1, M3, …) are referenced from the report. Superscript reference numbers fused into words by pdftotext (e.g. "path4–11") were dropped from the quotes; nothing else was changed.

---

## Edwards, Rolland & Keller 1993 — "Video see-through design for merging of real and virtual environments", IEEE VRAIS 1993, pp. 223–233
File: `Edwards_Rolland_Keller_1993_video_see-through_design.pdf` (source: https://api.creol.ucf.edu/Publications/1509.pdf)

- **E1** (pdf p.3, printed p.225): "Off-axisness (cameras viewing from above or below the eyes line of sight) can be hard to get used to when objects are close and can cause disorientation when walking."
- **E2** (pdf p.3, printed p.225): "Placing the cameras in front of the eyes as in Figure 2a and 2b result in the image of the outside world seen through the HMD appear magnified and closer than they actually are."
- **E3** (pdf p.3, printed p.225): "The potential problem is that the two senses of vision and proprioception (i.e. hand position) will be mismatched."
- **E4** (pdf p.2, printed p.224): "If only part of the detector area were to be mapped to the LCD screens, the projected outside scene would appear magnified since the LEEP optics would project a smaller FOV to a larger one. Hence the camera lenses FOV must exactly match the LEEP optics FOV."

## Rolland, Biocca, Barlow & Kancherla 1995 — "Quantification of adaptation to virtual-eye location in see-thru head-mounted displays", Proc. VRAIS '95, pp. 56–66
File: `Rolland_Biocca_1995_quantification_adaptation_virtual_eye.pdf` (source: https://api.creol.ucf.edu/Publications/1502.pdf). Conference precursor of Biocca & Rolland 1998 (Presence 7(3)), which was NOT retrieved.

- **R1** (pdf p.1, printed p.56, abstract): "The study looked at the effects of sensory rearrangement caused by a HMD design that displaces the user's “virtual” eye position forward (165 mm) and up (62 mm) toward the spatial position of the cameras. Measures of hand-eye coordination and speed on a manual task revealed substantial perceptual costs of the eye displacement, but also evidence of adaptation."
- **R2** (pdf p.1, printed p.56, abstract): "Speed of performance on a manual task decreased by 43% compared to baseline performance. Pointing accuracy improved by about a 113 [sic, OCR of "1/3"] as subjects adapted to the sensory rearrangement but did not reach baseline performance. When subjects removed the see-thru HMD there was evidence that their hand-eye coordination had been altered by the see-thru HMD. Negative aftereffects were observed in the form of greater errors in pointing accuracy compared to baseline."
- **R3** (pdf p.9, printed p.64): "When subjects were wearing the see-thru HMD that displaced their vision upwards, they tended to point downward of the actual target position."
- **R4** (pdf p.9, printed p.64): "When subjects wore the see-thru HMD that displaced their vision forward, they tended to point short of the target."
- **R5** (pdf p.9, printed p.64): "But the lines in Figure 6 are somewhat parallel suggesting that movement towards baseline performance might take quite a few rounds of extended practice."
- **R6** (pdf p.10, printed p.65): "Errors, which were on average low at baseline, increased by several 100% after putting on the see-thru HMD. The amount of error dropped by about l/3 [sic] as subjects began to adapt to the sensory rearrangement and would have probably dropped further over longer periods of time."
- **R7** (pdf p.10, printed p.65): "The HMD removed, subjects exhibited a negative aftereffect, overshooting the target in the pointing task in a direction opposite of the errors they made when they “entered” the virtual environment." [added by verifier]
- **R8** (pdf p.9, printed p.64): "Performance on a manual task requiring hand-eye coordination took 43% longer with the see-thru HMD." [added by verifier]

## Park, Serefoglou, Schmidt, Radermacher, Schlick & Luczak 2008 — "Hand-eye coordination using a video see-through augmented reality system", The Ergonomics Open Journal 1:46–53
File: `Park_2008_hand-eye_video_see-through_camera_displacement.pdf` (source: https://benthamopen.com/contents/pdf/TOERGJ/TOERGJ-1-46.pdf, CC BY-NC 3.0)

- **P1** (pdf p.1, printed p.46, abstract): "During the first experiment 15 camera positions with five levels of height displacement and three levels of depth displacement were compared in four different tasks. Using a two-way ANOVA, the comparison of the calculated performance characteristic values showed significant influence of height displacement on hand-eye coordination. In conclusion, cameras should be placed above or below eye level, but by no more than 35 mm, in order to preserve hand-eye coordination."
- **P2** (pdf p.6, printed p.51): "The subjects showed significantly worse performance with the height displacement of 70 mm than with the height displacement of 35 mm above users’ eyes for all three levels of depth displacement (130 mm, 165 mm and 200 mm)."
- **P3** (pdf p.6, printed p.51): "While performing with cameras at eye level, subjects obscured the view of the target with their fingers or hand."
- **P4** (pdf p.6, printed p.51): "No significant effects of depth displacement were found during this experiment."
- **P5** (pdf p.6, printed p.51): "Even with the mirror system which allowed the cameras to be placed at eye level, significant differences were found between performance accuracy with the HMD and without the HMD. These findings implicate the strong effect of other system related factors on performance, such as the restricted field of view, weight of the HMD, absence of depth cues, time lag etc."
- **P6** (pdf p.2, printed p.47): "For each step, 20 subjects performed experimental tasks with the five camera positions, in total 60 subjects for the entire experiment." … "In order to compare the five camera height displacements during each step, a within subject design was chosen, whereas to test the depth displacement a between subjects" [design; added by verifier]

## Mullins 2008 — "Development of indirect view sensor systems: effects of viewpoint offset on human performance", Proc. 26th Army Science Conference (DTIC ADA505752)
File: `Mullins_2008_ADA505752_indirect_view_viewpoint_offset.pdf` (source: Wayback copy of https://apps.dtic.mil/sti/pdfs/ADA505752.pdf; DTIC itself was "Under Maintenance" on 2026-11-03). pdf p.2 is the DTIC SF-298 form; the paper has no printed page numbers.

- **M1** (pdf p.1): "In navigation tasks, Soldiers who experienced incidents of disorientation and problems navigating through the environment often walked into objects (Redden et al., 2005)."
- **M2** (pdf p.1): "Seventeen participants, 10 males and 7 females, with a mean age of 24.41 years participated in the mobility course task."
- **M3** (pdf p.3): "A Sony day camera, 40-degree field of view sensor, and a Kopin, 24.6-mm diagonal, monochromatic display were mounted on the helmet. Four sensor locations (Figure 1) were tested: centered above the eyes, directly in front of the HMD, vertically above the HMD, and directly in front of the HMD but shifted forward 17.8 cm along the z-axis (front forward). A patch was worn over the eye without the display."
- **M4** (pdf p.3, Fig. 1 caption): "(d) above – sensor above the eye in vertical alignment with the display (vertical offset); (e) center – sensor above the display and centered above the eyes (vertical and horizontal offset)."
- **M5** (pdf p.4): "Obstacles included furniture, windows, doorways, steps, and a ramp."
- **M6** (pdf p.5): "Compared to the front position, the time required to complete the course took 2.9%, 14.2%, and 16.1% longer for the front forward, above, and center positions, respectively. Participants made 14.3% and 19.9% more errors for the above and center positions, respectively. Results indicate that errors decreased by 21.6% for the front forward position when compared to the front position."
- **M7** (pdf p.6): "The vertical offset (above and center positions) required significantly more time to complete the course when compared to the front and front forward sensor positions. Pairwise comparisons of the total errors indicated that errors were significantly lower for the front forward position when compared to the center and above positions."
- **M8** (pdf p.6): "Compared to the front position, participants took 8.3%, 22.8%, and 34.2% more time to complete the task for the front forward, above, and center positions, respectively."
- **M8b** (pdf p.6): "The above location, with a vertical offset, was ranked third by the majority of participants. The center location, with a vertical and horizontal offset, was ranked as the least preferred by the majority of participants."
- **M9** (pdf p.8): "With the center position, the retinal image shifted so that objects in the environment that appeared to be straight ahead were actually positioned to one side of the participant, thus, contributing to declines in performance."
- **M10** (pdf p.8): "Objective performance measures indicate that placing the sensor in front of the display (when possible from a design standpoint) is preferable."
- **M11** (pdf p.4): "After the baseline conditions, the participant donned the viewpoint offset apparatus and the display was placed over his or her preferred eye." [added by verifier]
- **M12** (pdf p.4, Fig. 2 "Mobility Course Layout" labels): "275 LUX" / "190 LUX" / "312 LUX" / "359 LUX" [added by verifier]

## CuQlock-Knapp, Myles, Malkin & Bender 2001 — "The effects of viewpoint offsets of night vision goggles on human performance in a simulated grenade-throwing task", ARL-TR-2407
File: `CuQlock-Knapp_2001_ARL-TR-2407_NVG_viewpoint_offset_grenade.pdf` (source: https://www.govinfo.gov/content/pkg/GOVPUB-D101-PURL-gpo2599/pdf/GOVPUB-D101-PURL-gpo2599.pdf)

- **C1** (pdf p.4, abstract): "Results also indicated that the horizontal component of a mixed horizontal and vertical offset NVG design accounts for most of the errors in performance. The results suggest that soldiers will need to practice throwing grenades while wearing NVGs with viewpoint offsets in order to approach the same accuracy level as with non-offset NVGs."
- **C2** (pdf p.12, printed p.4): "The present task required each participant to throw 10 grenades, one at a time, onto a simulated trap door from 20 feet away."
- **C3** (pdf p.16, printed p.8): "Three of the NVGs had an attached zig-zag mirror system to displace the viewpoint of each eye 3 inches from the LOS in normal unaided viewing"
- **C4** (pdf p.14, printed p.6, Fig. 2 labels): "Control condition: no vi&point [sic] displacement" / "Viewpoints displaced Vertically downward only" / "Viewpoints displaced horizontally outward only" / "Viewpoints displaced downward and outward"
- **C5** (pdf p.19, printed p.11): "The performance of the participants who wore the NVGs with the vertical offset was not significantly different from the performance of the participants who wore the normal goggle on any of the three measures: hits, range, or pull."
- **C6** (pdf p.24, printed p.16): "Since this experiment did not allow time for participants to adapt to the viewpoints, our data can address only the magnitude of the expected effect of hyperstereo."

## Rash, Russo, Letowski & Schmeisser (eds.) 2009 — "Helmet-Mounted Displays: Sensation, Perception and Cognition Issues", USAARL
Files: `USAARL_HMD2009_Section-*.pdf` (source: https://usaarl.health.mil/index.cfm/publications/books)

- **H1** (Ch.17 "Guidelines for HMD design", pdf p.19, printed p.823): "More recently long-wave thermal imaging has been added for dismounted Warfighters, under a program called Enhanced Night Vision Goggle (ENVG) and designated the AN/PSQ-20. These sensor systems typically mount to the front of the Warfighter’s helmet, with the entrance aperture in line with the user’s eye. While aiding the Warfighter in low light or night time conditions, these sensors have an adverse effect on head-supported weight and CM because the components protrude out in front of the user’s face. A better approach would be to integrate the sensor hardware into the helmet so as to minimize bulk and protrusions and to better optimize weight and balance. Unfortunately, this can create an offset of the sensor aperture with respect to the wearer’s normal line-of-sight."
- **H2** (Ch.17, pdf p.19, printed p.823): "Melzer and Moffitt (2007) investigated the perceptual and performance effects of viewing offset (forward, high and centered and side) monocular sensor video, replicating potential integrated design solutions for dismounted Warfighter applications. The results indicated little or no eye dominance issues but demonstrated that the sensor and display must be aligned to within 0.5°. If the alignment error was in the horizontal plane, subjects walked in an arc, rather than in a straight line."
- **H3** (Ch.17, pdf p.19, printed p.823): "Melzer and Moffitt (2007) also found that when aligned, the high-mounted sensor gave an indication of a slated [sic] floor, and the side mounted sensor produced a blind pointing error that was opposite of the sensor location. However, as long as the test subjects were able to view their feet and hands, they were able re-calibrate their hand-eye coordination to perform close-in tasks, albeit with some temporary after effects (Bertelson and de Gelder, 2004)."
- **H4** (Ch.17, pdf p.34, printed p.838): "Considerations for helmet-mounted sensors – Adding sensors to a Warfighter’s helmet (e.g., the AN/PVS-14 or AN/PSQ-20) augments their vision under low light conditions, but when configured in line with their eyes may have negative head-supported weight and CM/CG effects. Mounting the sensors at a more favorable location on the top or sides of the helmet may present adverse perceptual artifacts such as offset hand-eye coordination (monocular) or hyperstereopsis (binocular). Limited data indicate that a perceptual re-calibration is possible, though with unknown residual aftereffects. Research is continuing in this area."
- **H5** (Ch.4 "Visual helmet-mounted displays", pdf p.7, printed p.115): "This example HMD is binocular in its optical design for thermal imagery, but since there is a single infrared sensor, the thermal image is repeated to both eyes, which results in a biocular HMD system." … "Another challenging characteristic will be switching from the biocular thermal sensor, with no stereopsis, to a hyperstereo I2 scene."
- **H6** (Ch.12 "Visual perceptual conflicts and illusions", pdf p.19, printed p.509): "In 2005, the USAARL conducted a flight investigation in the UH-60 where aviators serving as the co-pilot (but not on the controls) wore the TopOwl HMD. Subjects reported an approximate 6-8 hours acclimation period that is consistent with manufacturer’s claims."
- **H7** (Ch.12, pdf p.65, printed p.555): "The relatively slow retinal processing (around 70 ms) cannot compensate for head movement, but the vestibular system via the vestibulo-ocular reflex (VOR) with latency of less than 16 ms can."

## Penner, D'Angelo, Smith, Matsuda, Siva & Guan 2026 — "Perceptual requirements for low-latency head-mounted displays", arXiv:2603.15796
File: `Penner_2026_arXiv2603.15796_low-latency_passthrough_requirements.pdf` (source: https://arxiv.org/pdf/2603.15796)

- **Pn1** (pdf p.1): "In modern devices this latency is usually in the range of 12-60 milliseconds which is partially addressed through pose prediction and late stage reprojection"
- **Pn2** (pdf p.1): "studies and 57 participants we find that 2 and 14.3 millisecond latencies are preferred over 23 and 29 milliseconds when attempting to catch a ball."
- **Pn3** (pdf p.2): "In passthrough headsets, the entire passthrough feed is delayed so the world may appear world-locked and stable, but haptic and proprioceptive feedback from physical interactions with the world will not be aligned with visual input."
- **Pn4** (pdf p.2): "Elbamby et al. [2018] cite "broad census" that e2e latency should kept below 15–20 ms to provide a pleasant immersive experience, but such numbers are difficult to validate"
- **Pn5** (pdf p.3): "While most video mediums are not highly latency sensitive, a few have continued to optimize for latency, such as first-person-view (FPV) drone operation [Pfeiffer et al. 2021]. While some of these systems claim to achieve latencies similar to Camsicle [Divimath, Inc. 2024], these mono camera systems do not account for capture or viewing optics."
- **Pn6** (pdf p.6): "Performance was significantly improved at 2 ms compared to 29 ms across all tasks. Similar significant improvements were observed when comparing 14.3 ms to 29 ms for the ball catching and reaction time tasks, with the maze task showing a similar trend (𝑝 = 0.09)."
- **Pn7** (pdf p.1, Fig. 1 caption): "We present a video passthrough headset achieving 2 millisecond end-to-end (e2e) latency. A catadioptric design employs world-facing mirrors to align the passthrough cameras with the user’s physical eye position in the HMD, minimizing perspective error to ensure latency is the primary variable under study."

## Jerald 2010 — "Scene-motion- and latency-perception thresholds for head-mounted displays", PhD dissertation, UNC Chapel Hill (TR10-013)
File: `Jerald_2010_latency_perception_thresholds_HMD_UNC_dissertation.pdf` (source: https://techreports.cs.unc.edu/papers/10-013.pdf)

- **J1** (pdf p.37, §1.8.2): "Latency thresholds decrease as peak head-yaw acceleration increases. The minimum measured latency threshold is 3.2 ms. This suggests that latency requirements should be in the 3 ms range, although the exact number may vary depending on the specific conditions of the IVE."
- **J2** (pdf p.145): "The mean latency difference threshold across all subjects and all six deciles was 16.9 ms with a standard deviation of 10.4 ms. The lowest difference threshold was 3.2 ms and the highest difference threshold was 60.5 ms."
- **J3** (pdf p.191, §10.3): "The thresholds I measured provide guidelines for latency, but I do not claim that these thresholds will necessarily hold across all conditions."
- **J4** (pdf p.106, §4.3.3): "I broke the 75% thresholds into 50% thresholds and difference thresholds (75% thresholds - 50% thresholds)" … "For yes/no judgments alone, my 50% threshold are equivalent to PSEs and my difference thresholds are equivalent to JNDs." [added by verifier]
- **J5** (pdf p.196): "The simulated-HMD system I built with off-the-shelf components contained 7.4 ms of system delay." [added by verifier]

## Bonnen, Matthis, Gibaldi, Banks, Levi & Hayhoe 2021 — "Binocular vision and the control of foot placement during walking in natural terrain", Sci. Rep. 11:20881, doi:10.1038/s41598-021-99846-0
File: `Bonnen_2021_SciRep_binocular_vision_foot_placement.pdf` (source: https://www.nature.com/articles/s41598-021-99846-0.pdf, open access)

- **B1** (pdf p.1, abstract): "The primary effect of increased sensory uncertainty due to disrupted binocular vision was a small bias in gaze towards closer footholds, indicating greater pressure on the visuomotor control process."
- **B2** (pdf p.1): "Controlled laboratory experiments directly examining vision and gait have established that walkers require information from around 2 steps ahead in order to successfully navigate collections of obstacles or targets along a smooth path"
- **B3** (pdf p.2): "More recent laboratory studies of walking and impaired binocular vision have noted that participants exhibit slower walking and raise the foot higher when stepping up to or over an obstacle"
- **B4** (pdf p.3): "Gaze angles around − 45◦ [sic] are closer to the walker, when gaze is allocated to the ground near 2–3 footholds ahead."
- **B5** (pdf p.5): "In the rougher terrain they slow down to about 0.8 m/s, from about 1.4 m/s on the pavement"
  (B5 is about terrain, not binocular disruption; it does not support the "speed unchanged" statement — see B6/B7.)
- **B6** (pdf p.5, section heading): "Walking speeds vary with terrain (but not with binocular information)." [added by verifier]
- **B7** (pdf p.7): "We found no significant differences in the median walking speeds when compared on a within participants basis" [added by verifier]
- **B8** (pdf p.2): "During one of the walks we impaired participants’ binocular vision by blurring the input to one eye using a Bangerter Occlusion Foil" [added by verifier]

## Balachandran 2024 — "Navigating virtual realms: discovering the impact of head-mounted displays on human gait using wearable sensor motion capture", MEng thesis, University of Auckland
File: `Balachandran_2024_Auckland_MEng_HMD_gait_thesis.pdf` (source: https://researchspace.auckland.ac.nz/items/42030b70-1b9e-466a-a855-602310872e47)

- **Ba1** (pdf p.4, abstract): "OMC and IMU data were collected on a pilot dataset of 20 healthy participants subject to trials under three testing conditions: Normal, using an optical see-through Augmented Reality (AR) display, and using a video see-through Virtual Reality (VR) display."
- **Ba2** (pdf p.4, abstract): "However, post-hoc analyses on the results frequently revealed low statistical significance and a greater sample size was required. The observed changes included a decreased gait velocity and cadence (aka step frequency), as well as increases in stride time, reaction time, task completion time, and cumulative knee flexion throughout strides."
- **Ba3** (pdf p.9 and p.30): "The Quest 3 was used in this study."
- **Ba4** (pdf p.68): "The velocity of participants decreased by an average 0.1 ± 0.1m/s during the Free Path and 0.1 ± 0.1m/s during the Reactive Start/Stop task."
- **Ba5** (pdf p.4, abstract): "Observing the changes in the extracted gait metrics reflected participants slowing down and acting more cautiously while wearing the HMDs." … "An increase in the cumulative knee and hip flexions and marker/sensor heights were also observed during obstacle clearance." [pooled over AR and VR HMDs; added by verifier]
- Context for Ba4 (pdf p.68): the sentence sits under "3.2 The VR Condition / 3.2.1 OMC Results", i.e. it is the Quest 3 video see-through condition. [verifier note]

## Fat Shark Dominator HDO2 user manual, Rev C
File: `FatShark_HDO2_Manual_RevC.pdf` (fetched by the hardware track; only the line below used here)

- **F1** (pdf p.11, specifications): "FOV (field of view): 46 degrees diagonal"

## BZB UAS shop page — Caddx TR1-220SL Dual (English)
File: `bzbuas_tr1-220sl_product_page_en.txt` (saved page text; fetched by the camera track). Shop claims, not manufacturer documentation. [section added by verifier]

- **S1** (specifications): "Average Latency" / "20ms" … "AI box size" / "33.5x33.5x16.5mm" / "Weight" / "55g"
- **S2** (specifications): Camera 1 (Infra) "Camera size" / "20x20.5x34.5 mm"; Camera 2 (Thermovision) "Camera size" / "19.5x19.5x20mm"

## ITU-R BT.470-6 — Conventional television systems
File: `ITU-R_BT.470-6_TV_systems.pdf` (fetched by another track). [section added by verifier]

- **T1** (pdf p.2, Table 1 "Basic characteristics of video and synchronizing signals", item 2): "Field frequency, nominal value (field/s)" — 50 for the 625-line systems B, G, H, I, D, K (60 for system M). 1/50 s = 20 ms [C].
