asdfgh0318/arabskie_gogle/papers/README.md

# papers/ — źródła researchu

Pliki źródłowe (PDF, zapisane strony, obrazy) są **tylko lokalnie** (`.gitignore`) — repo jest publiczne.
W repo są cytaty `extracts_*.md` (cytat + plik + strona) dla każdego tagu [V] w `research/`.

## Pobrane lokalnie (stan 2026-11-03)
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
