asdfgh0318/arabskie_gogle/cad/img/adapter_top.png

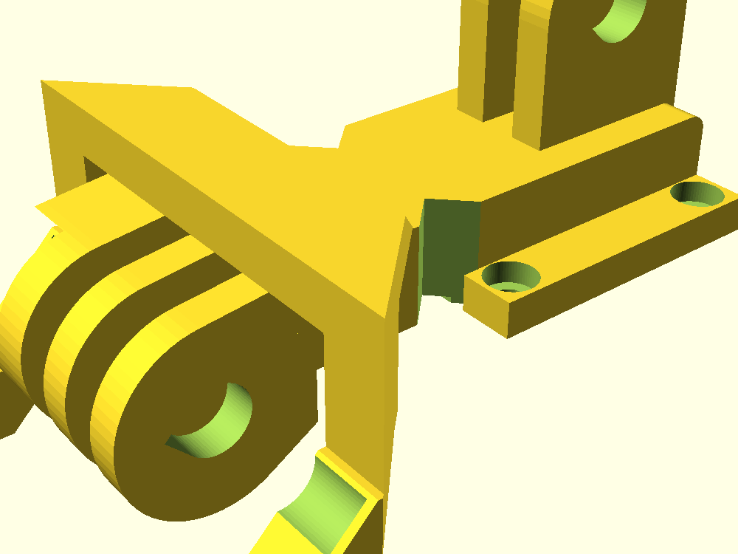
cad/img/adapter_top.png
