asdfgh0318/arabskie_gogle/cad/img/cage_rear.png

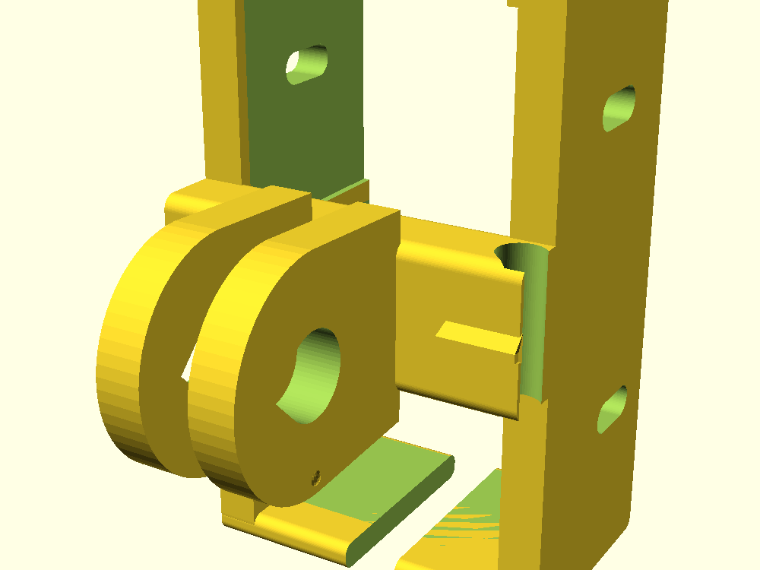
cad/img/cage_rear.png
