asdfgh0318/arabskie_gogle/cad/img/coupon.png

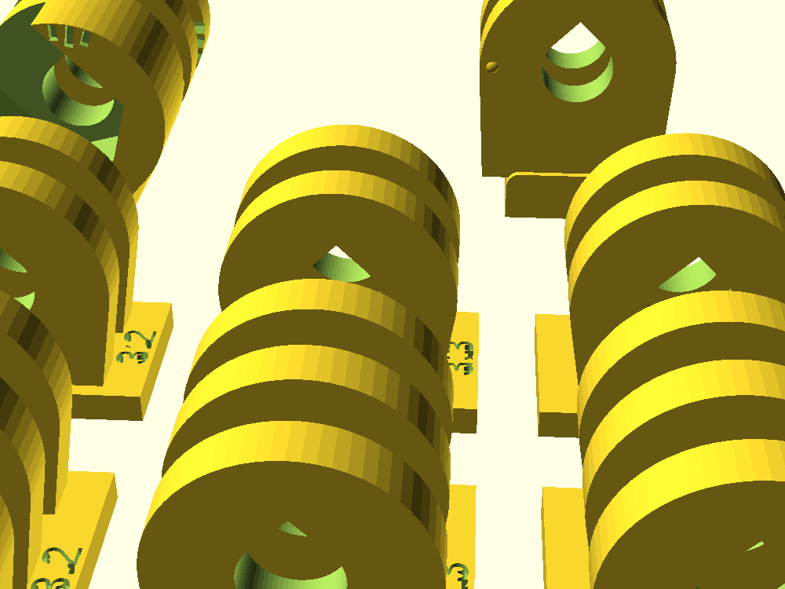
cad/img/coupon.png
