asdfgh0318/arabskie_gogle/cad/img/front.png

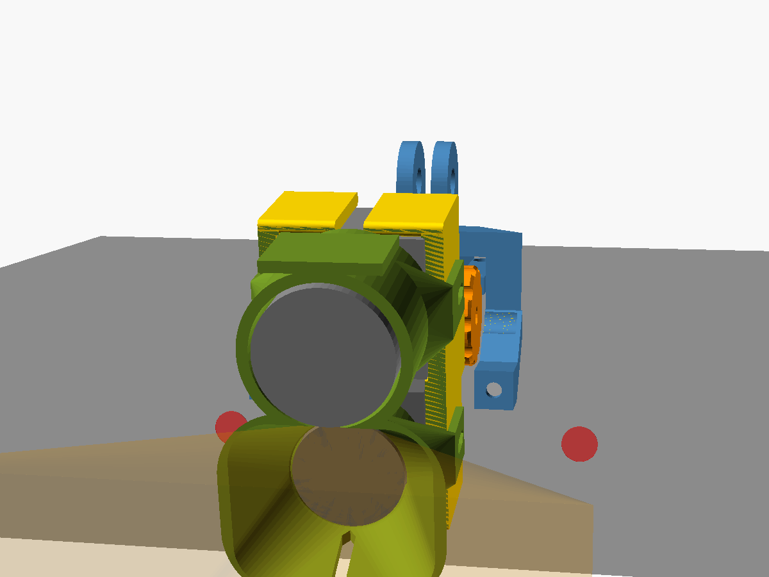
cad/img/front.png
