asdfgh0318/arabskie_gogle/cad/img/pod_inside.png

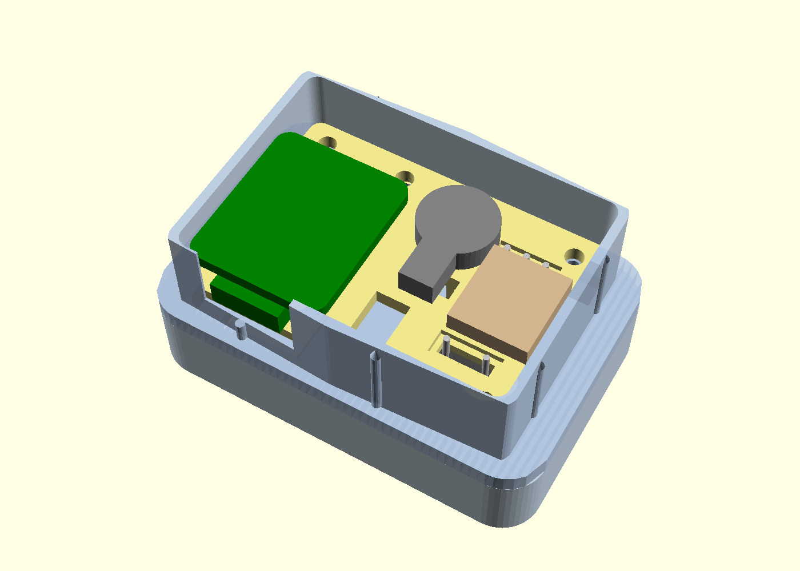
cad/img/pod_inside.png
