asdfgh0318/arabskie_gogle/cad/img/side_t0.png

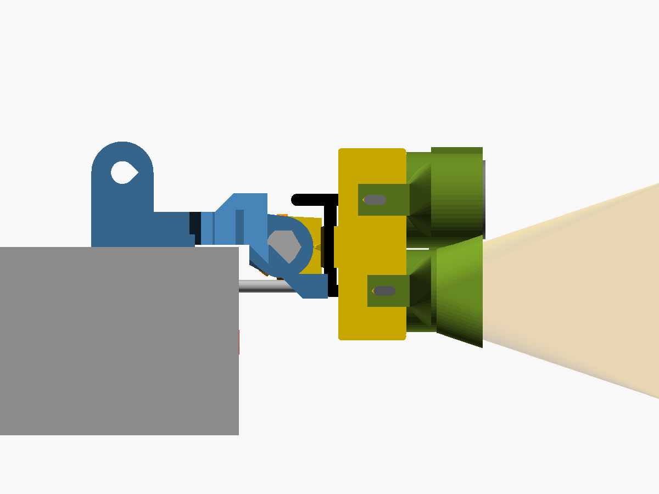
cad/img/side_t0.png
