asdfgh0318/arabskie_gogle/cad/img/side_t20.png

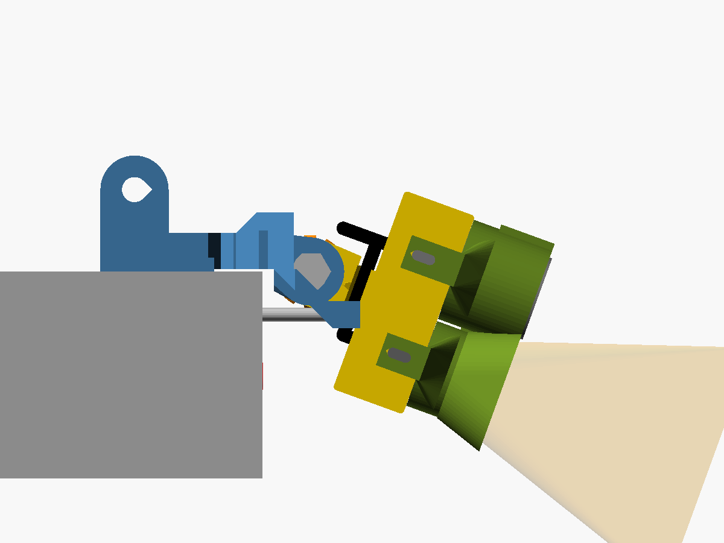
cad/img/side_t20.png
