asdfgh0318/arabskie_gogle/cad/img/tac_side_t0.png

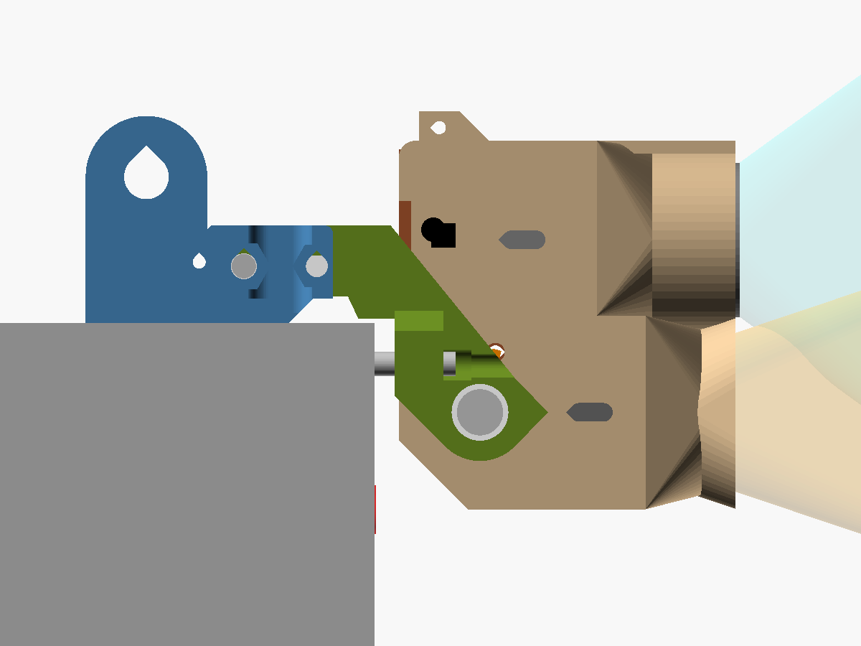
cad/img/tac_side_t0.png
