asdfgh0318/arabskie_gogle/cad/img/tac_side_t20.png

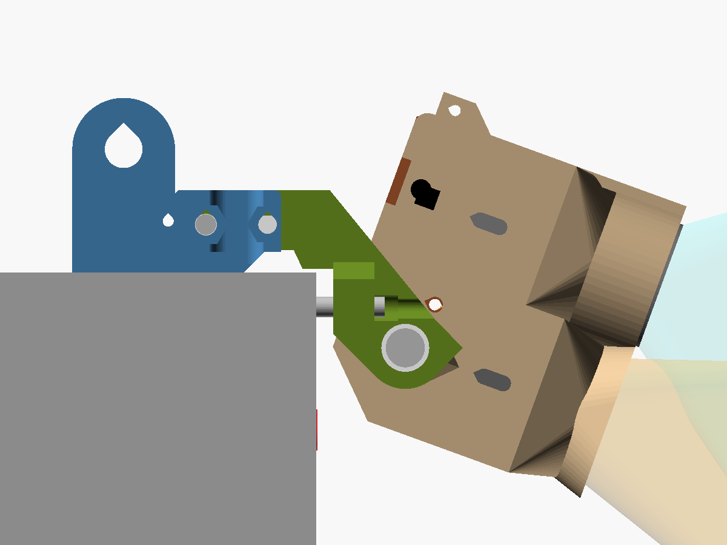
cad/img/tac_side_t20.png
