asdfgh0318/arabskie_gogle/cad/stl/print_knob.stl

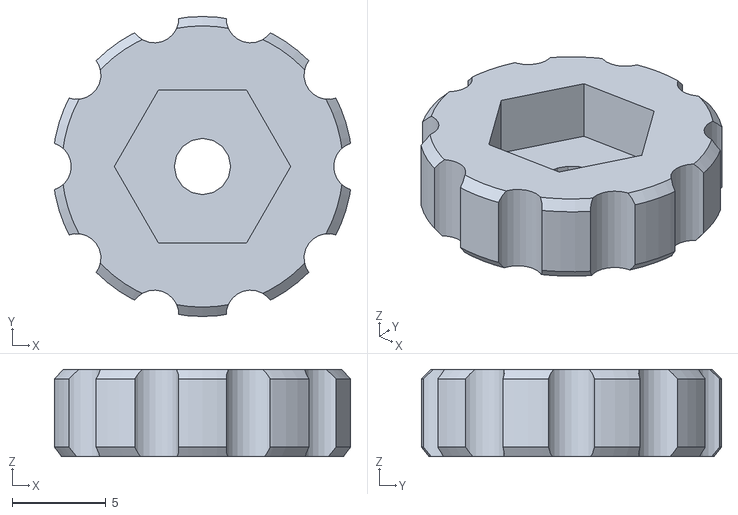
[picture p12: CAD file, 2026-11-06]
cad/stl/print_knob.stl
15.8 x 16.0 x 4.65
