asdfgh0318/arabskie_gogle/cad/stl/print_cage.stl

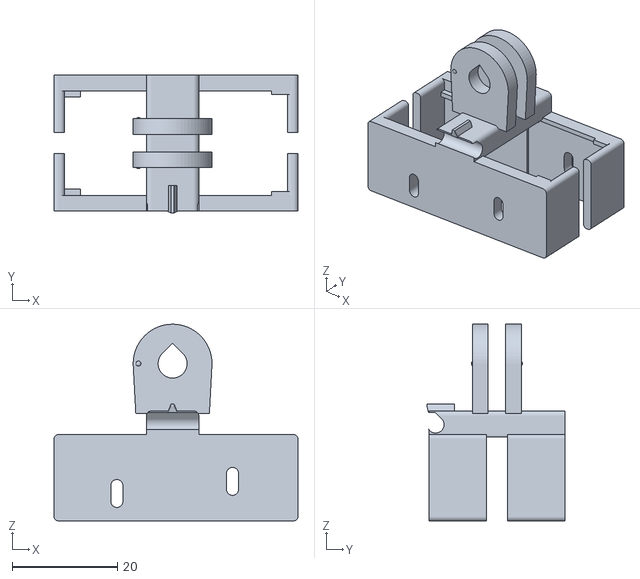
[picture p13: CAD file, 2026-11-06]
cad/stl/print_cage.stl
46.4 x 26.2 x 37.4
