asdfgh0318/arabskie_gogle/cad/stl/print_shroud.stl

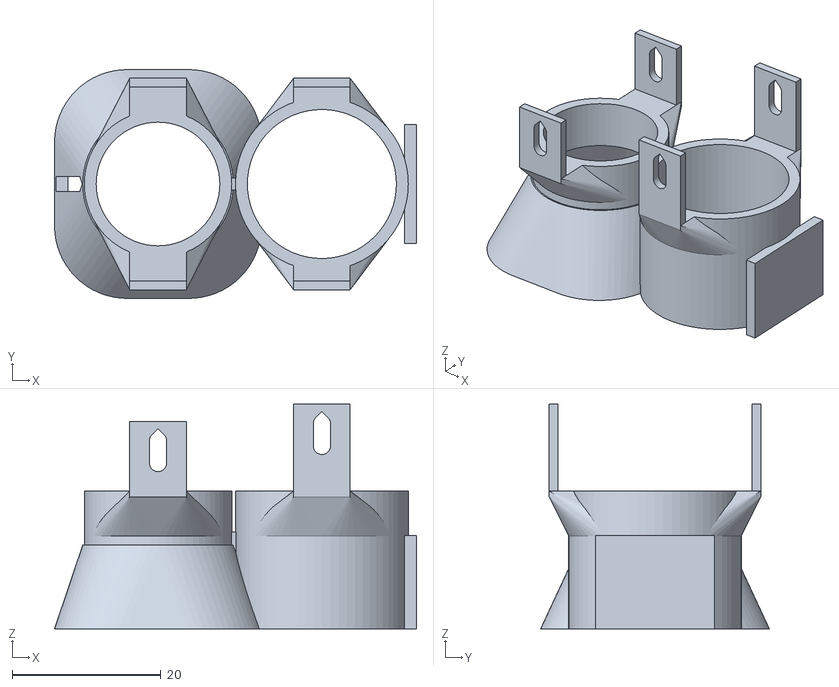
[picture p14: CAD file, 2026-11-06]
cad/stl/print_shroud.stl
48.6 x 30.7 x 30.1
