asdfgh0318/arabskie_gogle/cad/stl/print_adapter.stl

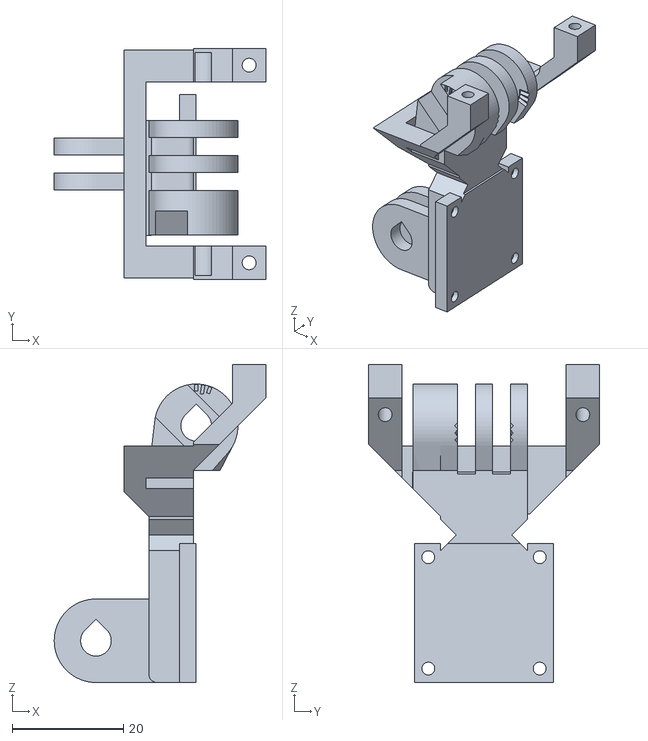
[picture p15: CAD file, 2026-11-06]
cad/stl/print_adapter.stl
38.0 x 41.5 x 57.1
