asdfgh0318/arabskie_gogle/cad/stl/coupon.stl

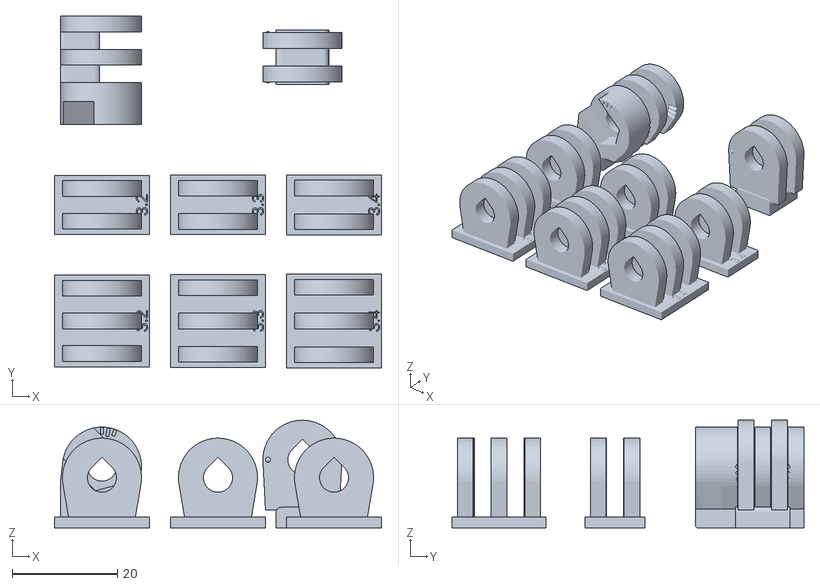
[picture p16: CAD file, 2026-11-06]
cad/stl/coupon.stl
62.0 x 66.7 x 20.4
