asdfgh0318/arabskie_gogle/cad/stl/tac_print_fork.stl

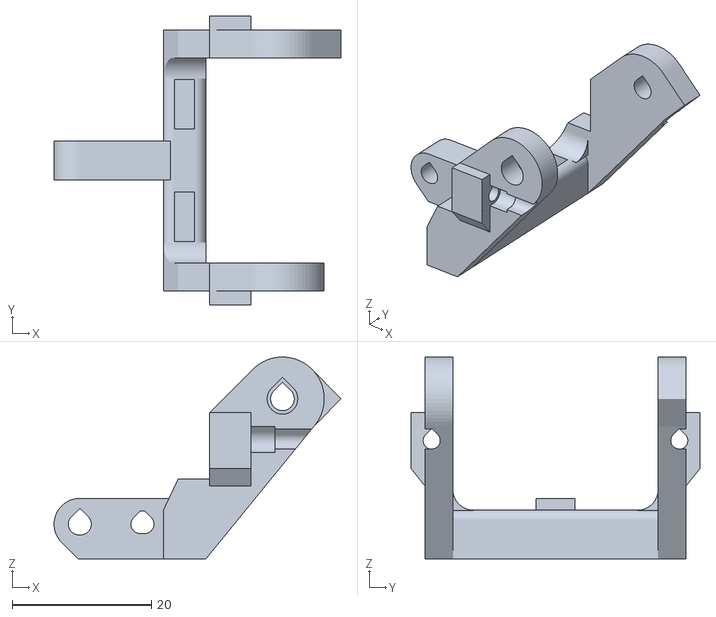
[picture p17: CAD file, 2026-11-04]
cad/stl/tac_print_fork.stl
41.2 x 41.5 x 29.0
