asdfgh0318/arabskie_gogle/cad/stl/tac_print_base.stl

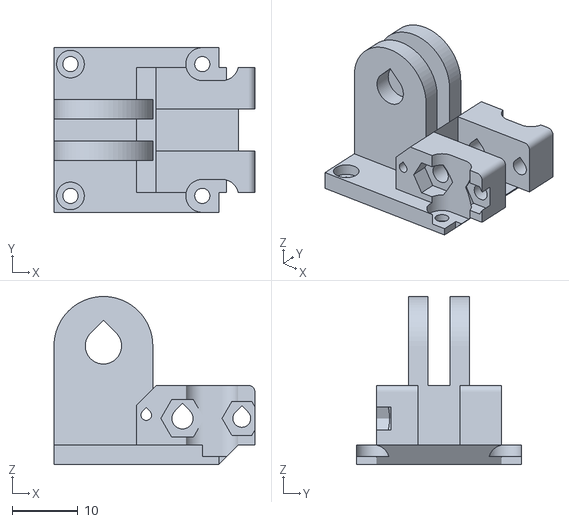
[picture p18: CAD file, 2026-11-04]
cad/stl/tac_print_base.stl
30.5 x 25.0 x 25.5
