asdfgh0318/arabskie_gogle/cad/stl/tac_coupon_joint.stl

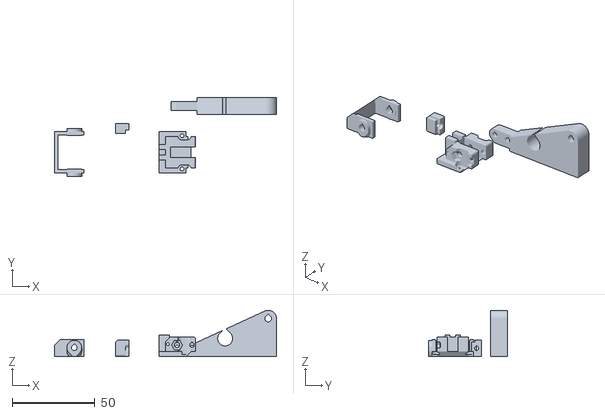
[picture p19: CAD file, 2026-11-04]
cad/stl/tac_coupon_joint.stl
133.9 x 47.5 x 28.0
