asdfgh0318/arabskie_gogle/cad/stl/tac_print_cage.stl

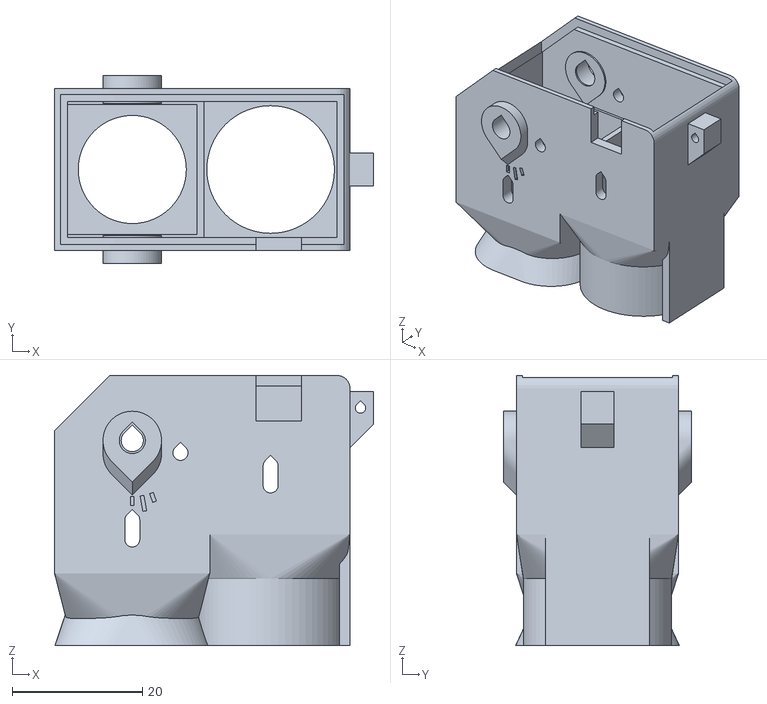
[picture p20: CAD file, 2026-11-04]
cad/stl/tac_print_cage.stl
49.0 x 28.9 x 41.5
