asdfgh0318/arabskie_gogle/cad/stl/tac_print_acc.stl

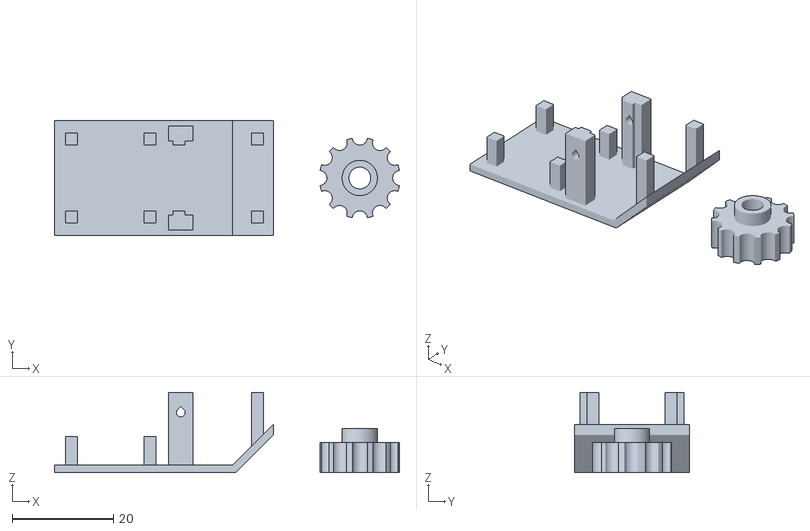
[picture p21: CAD file, 2026-11-04]
cad/stl/tac_print_acc.stl
68.3 x 22.8 x 15.9
