asdfgh0318/arabskie_gogle/cad/stl/tac_coupon.stl

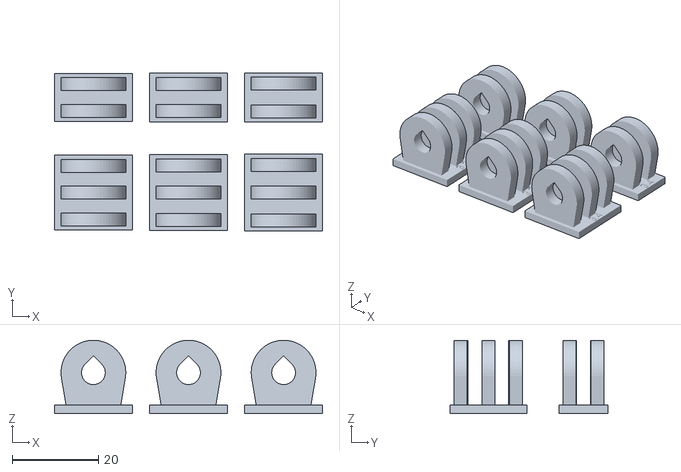
[picture p22: CAD file, 2026-11-04]
cad/stl/tac_coupon.stl
62.0 x 36.6 x 17.0
