asdfgh0318/arabskie_gogle/cad/stl/pod_print_gauge.stl

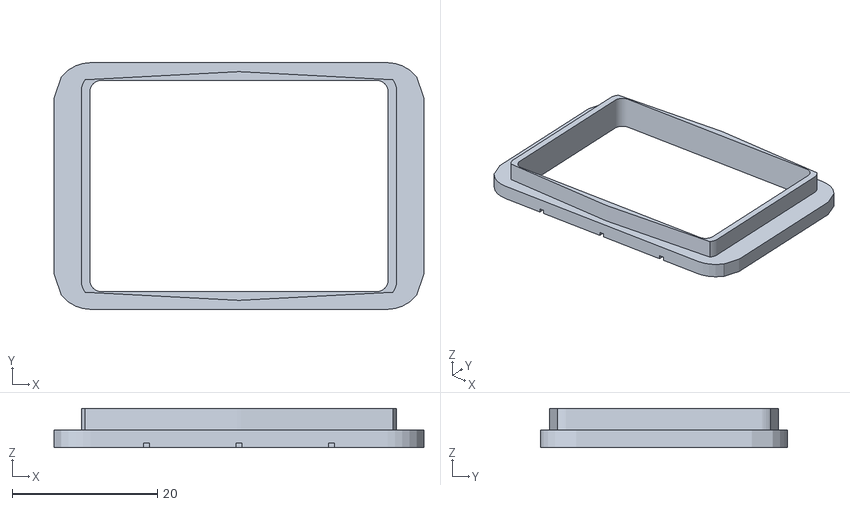
[picture p23: CAD file, 2026-11-03]
cad/stl/pod_print_gauge.stl
51.0 x 34.0 x 5.40
