asdfgh0318/arabskie_gogle/cad/stl/pod_print_shell.stl

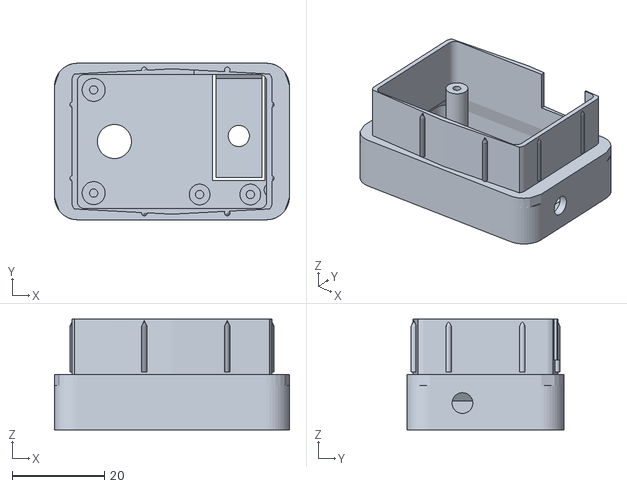
[picture p24: CAD file, 2026-11-03]
cad/stl/pod_print_shell.stl
51.0 x 34.0 x 24.0
