asdfgh0318/arabskie_gogle/cad/stl/pod_print_chassis.stl

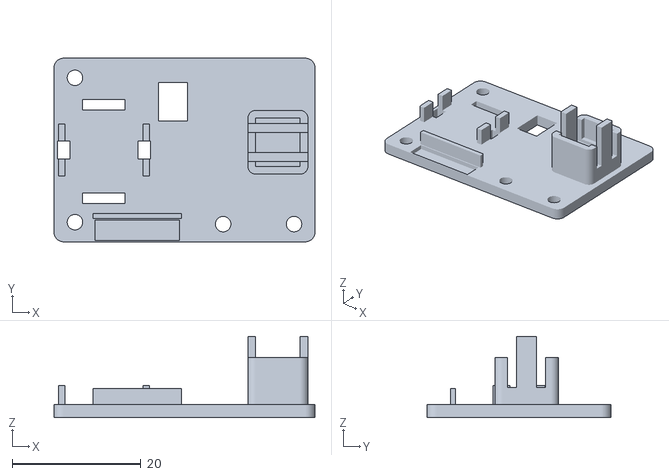
[picture p25: CAD file, 2026-11-03]
cad/stl/pod_print_chassis.stl
40.5 x 28.5 x 12.6
