asdfgh0318/arabskie_gogle/cad/stl/pod_print_knob.stl

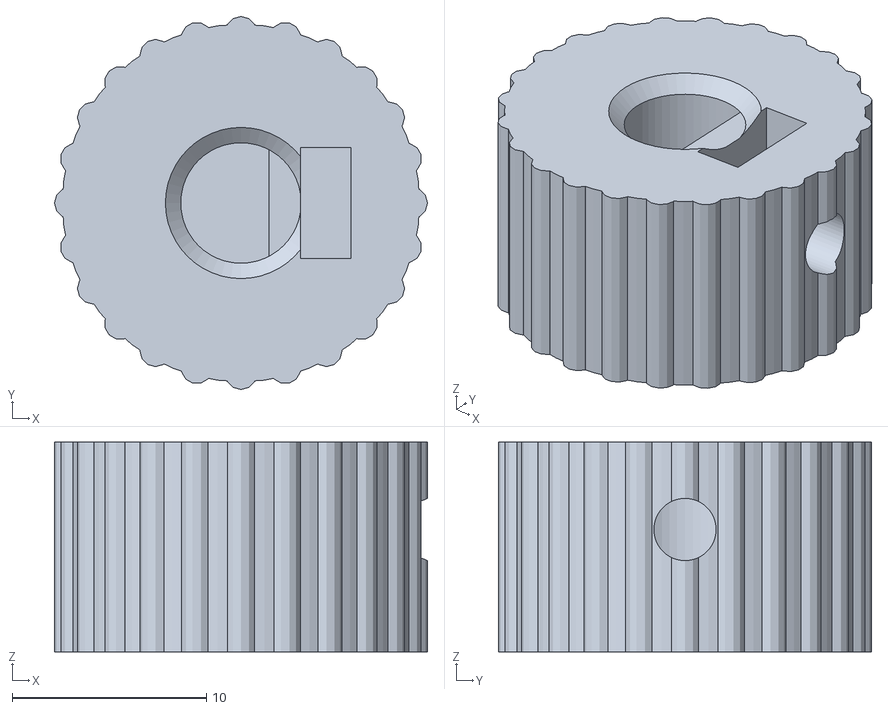
[picture p26: CAD file, 2026-11-03]
cad/stl/pod_print_knob.stl
19.2 x 19.2 x 10.8
