asdfgh0318/arabskie_gogle/cad/stl/pod_print_caps.stl

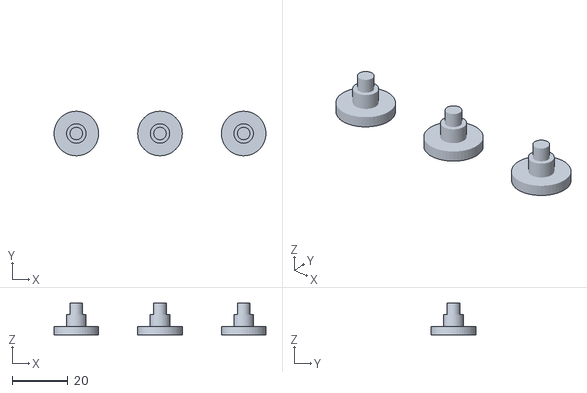
[picture p27: CAD file, 2026-11-03]
cad/stl/pod_print_caps.stl
76.0 x 16.0 x 11.3
