asdfgh0318/arabskie_gogle/cad/stl/pod_print_shims.stl

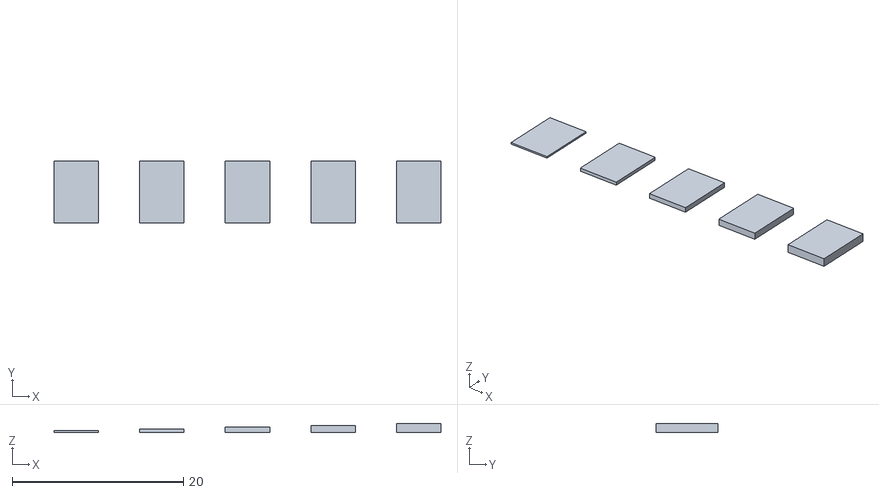
[picture p28: CAD file, 2026-11-03]
cad/stl/pod_print_shims.stl
45.2 x 7.20 x 1.00
