asdfgh0318/arabskie_gogle/cad/img/assembly_iso.png

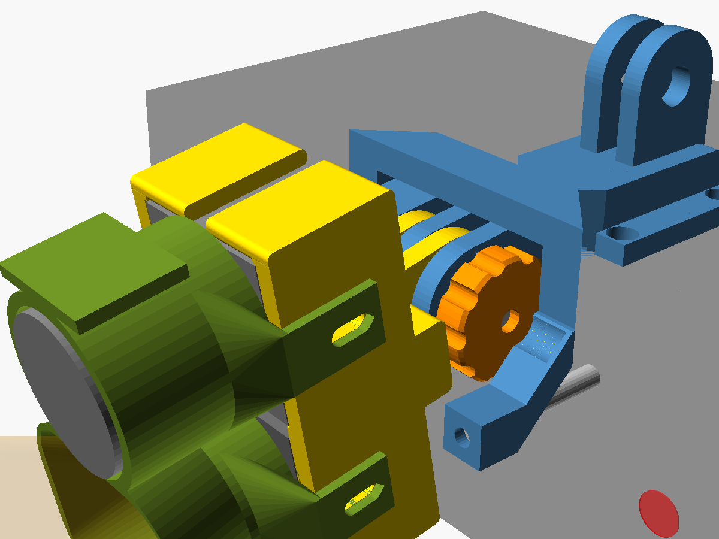
cad/img/assembly_iso.png
