asdfgh0318/arabskie_gogle/cad/img/pod_assembly.png

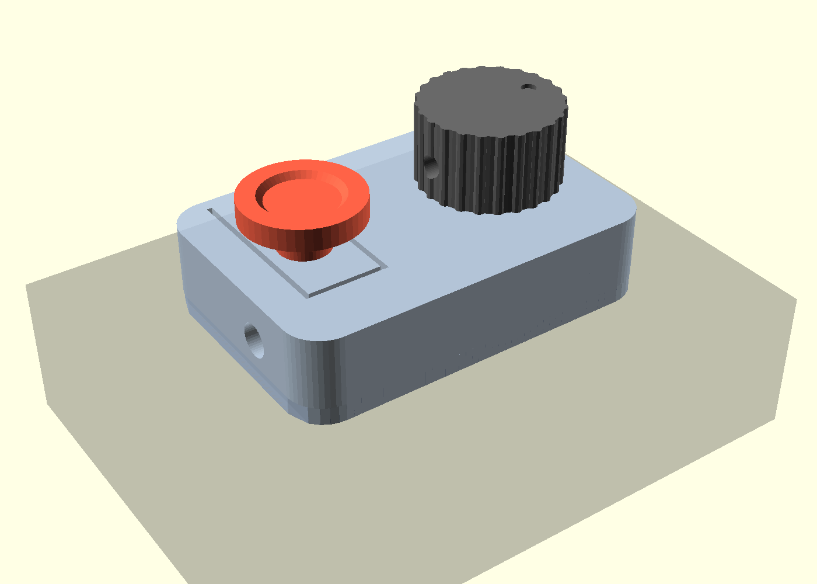
cad/img/pod_assembly.png
