asdfgh0318/arabskie_gogle/cad/img/tac_assembly_iso.png

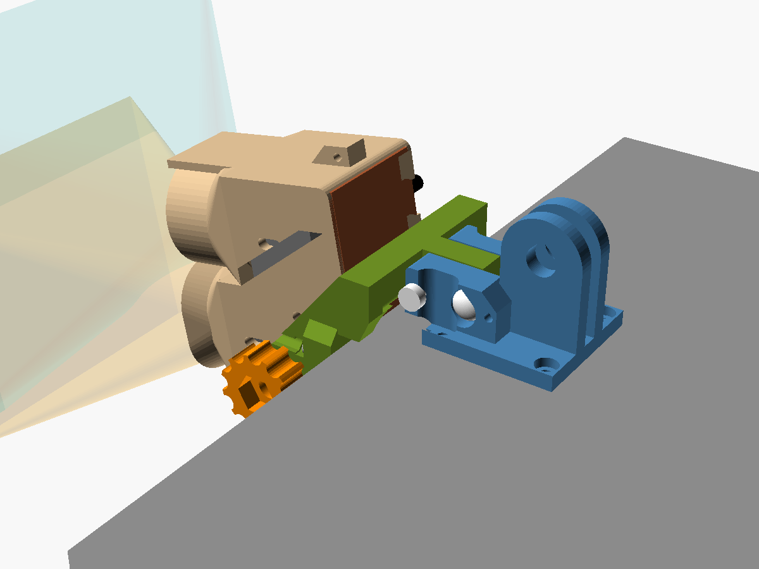
cad/img/tac_assembly_iso.png
