asdfgh0318/arabskie_gogle/(commit log)

2026-11-03 Research 01-05 (pozycja kamery, FOV, interfejs Caddx, HDO2/kask, sterownik/zasilanie) + wnioski w założeniach
    Źródła lokalnie (gitignore), w repo tylko cytaty extracts_*.md.
    Poprawka: powiększenie termo na HDO2 ≈0,75×, nie 0,92×.
2026-11-03 CAD v0.1: parametryczne mocowanie kamer (klatka + adapter na wentylator HDO2, przegub GoPro)
    [camera_mount.scad]
2026-11-03 CAD v0.2 klatka: druk przodem w dół, szczeliny na przewody, zderzaki yaw, mocniejsza belka, łezka M5, wskaźnik pochylenia, ir_yaw_trim
    Poprawki z przeglądu adwersarialnego v0.1 (print/fit/optics/mech).
    [camera_mount.scad]
2026-11-03 CAD v0.2: adapter na gnieździe wentylatora na górze HDO2, próbka przegubu GoPro, STL do druku; research 06 (przód HDO2, GoPro)
    [camera_mount.scad, coupon.stl, print_adapter.stl, print_cage.stl]
2026-11-03 CAD v0.3: poprawki z 2. przeglądu — adapter nie wchodzi w krawędź gogli, bezpiecznik w bloku, zderzaki i belka klatki, th_yaw_trim, seat_pitch, podziałka 0/10/20, łezki, próbka w parach, test kolizji
    Test kolizji (tilt 0/10/20 × przód gogli 21.6/23.1/24.6): brak kolizji po rozszerzeniu wycięcia o front_tol.
    [camera_mount.scad, clash.scad, coupon.stl, print_adapter.stl, print_cage.stl]
2026-11-03 Research 07: pod sterownika — wymiary części (EC11E, B3S, XIAO C3, D36V6F5, JST-GH), miejsce na HDO2, ergonomia w rękawicach (MIL-STD-1472H) i mocowanie VHB; zweryfikowane adwersarialnie
2026-11-03 Pod sterownika v0.2 w lewej zatoce VRx: obudowa w jednym kawałku, blok pomiarów P1, przycisk CAM z ogranicznikiem na płytce, podkładki B3S, gałka z M3, sprawdzian zatoki, test kolizji z wsuwaniem i r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
    Poprawki z adwersarialnego przeglądu v0.1: AUX usunięty, długość i nasada języczka, przelot przewodów,
    przetwornica nad płytką, szczelina USB-C otwarta od spodu, wyjście przewodu do tyłu.
    [pod.scad, pod_clash.scad, pod_print_caps.stl, pod_print_chassis.stl, pod_print_gauge.stl, pod_print_knob.stl, pod_print_shell.stl, pod_print_shims.stl]
2026-11-03 CAD v0.4: adapter na gnieździe wentylatora trzyma też gogle na kasku — 2 nogi GoPro nad płytką do klamry na podstawce VHB z przodu kasku (helm_*), poza bezpiecznikiem kamery; test kolizji OK
    [camera_mount.scad, print_adapter.stl]
2026-11-03 Całość na HDO2: scene_all.scad (gogle zastępcze z wymiarów), uchwyt AI Boxa na prawym boku (propozycja), pod v0.2.1 — wydruki odbite w x (układ był lewoskrętny), podgląd 3D offline w cad/web
    [aibox_mount.scad, pod.scad, pod_print_chassis.stl, pod_print_gauge.stl, pod_print_knob.stl, pod_print_shell.stl, scene_all.scad]
2026-11-03 scene_all: gogle z modelu GrabCAD (oryginalne HDO, plik lokalny, poza repo) zamiast bryły zastępczej; pod i AI Box w miejscu zatok z modelu; brak kolizji z korpusem
    [scene_all.scad]
2026-11-04 v0.5 PANCERZ+ (tactical_mount.scad): BASE z nogami do kasku, FORK na wymiennym bezpieczniku PA66 z popychaczami yaw na przedniej ścianie gogli, klatka-monokok na czopie z daszkiem termo i tubą Infra,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
    v0.4 (camera_mount.scad) bez zmian jako wersja zapasowa.
    [tac_coupon.stl, tac_coupon_joint.stl, tac_print_acc.stl, tac_print_base.stl, tac_print_cage.stl, tac_print_fork.stl, tactical_clash.scad, tactical_mount.scad]
2026-11-06 CAD v0.6: przegub GoPro przy kamerze wraca (decyzja Adama), zapadki pochylenia 0/10/20°, pokrętło M5 po lewej, popychacze M3 na przedniej ścianie (kierunek), nakładka z daszkiem termo i tubą Infra na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
    [camera_mount.scad, clash.scad, coupon.stl, export_parts.scad, print_adapter.stl, print_cage.stl, print_knob.stl, print_shroud.stl]
2026-11-06 Research 08: wymiary z modelu GrabCAD HDO (przód 21.7, zaokrąglenie krawędzi, oś okularów ≈22.5, drzwiczki 42×38) — potwierdzają założenia CAD w zakresie tolerancji
2026-11-06 Research 09: otwarte wymiary HDO2 z sieci — wentylator być może na zatrzaskiwanej osłonie przedniej (do sprawdzenia), złącze zatoki VRx 9 pin 2.54, drzwiczki rodziny Dominator, brak danych o kasku Pr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
2026-11-06 Firmware v0.1 sterownika (XIAO ESP32-C3): protokół Caddx FF 5A z CRC16/MODBUS, enkoder co 2 ząbki, przycisk CAM, tryby jasność/paleta/kontrast, NUC, hot-track, wibracje, alarm baterii 3S, zapis ustaw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
