asdfgh0318/arabskie_gogle/(notices)

Notices in the files:
research/05_controller_power.md:
4. FPV24 retailer citation: lines are L187–189, not L254–256.
